RotemCarr/snowboard-fc/hardware/docs/pinmap.md

# Snowboard Rev 3 pin map

Generated by `tools/gen_pinmap.py` from `snowboard_fc.kicad_sch`. Do not edit by hand:
change the schematic (and `EXPECTED` in the script if a pin moves), then regenerate.
Authoritative for the board DTS and pinctrl. Spec: SNB-HW-001 section 7.

## GPIO

| GPIO | Pin | Net | Peripheral | Dir | Connects to |
| --- | --- | --- | --- | --- | --- |
| 0 | 2 | `RX_TX` | UART0 TX | out | R24 100R → J3.3 (FC_TX) RX 4-pin SH |
| 1 | 3 | `RX_RX` | UART0 RX | in | R25 100R → J3.4 (FC_RX) RX 4-pin SH |
| 2 | 4 | `IMU_SCK` | SPI0 SCK | out | R10 33R → U5.13 (AP_SCLK) ICM-42688-P |
| 3 | 5 | `IMU_MOSI` | SPI0 TX | out | U5.14 (AP_SDI) ICM-42688-P |
| 4 | 7 | `IMU_MISO` | SPI0 RX | in | U5.1 (AP_SDO/AD0) ICM-42688-P |
| 5 | 8 | `IMU_CS` | GPIO (SPI0 CS) | out | U5.12 (AP_CS) ICM-42688-P |
| 6 | 9 | `IMU_INT1` | GPIO interrupt | in | U5.4 (INT1) ICM-42688-P |
| 7 | 10 | — | not connected | — | — |
| 8 | 12 | `M1` | PIO0 (DShot) | out | R16 100R → J1.3 (M1) ESC 8-pin SH |
| 9 | 13 | `M2` | PIO0 (DShot) | out | R17 100R → J1.4 (M2) ESC 8-pin SH |
| 10 | 14 | `M3` | PIO0 (DShot) | out | R18 100R → J1.5 (M3) ESC 8-pin SH |
| 11 | 15 | `M4` | PIO0 (DShot) | out | R19 100R → J1.6 (M4) ESC 8-pin SH |
| 12 | 16 | `AUX_TX` | PIO UART TX | out | JP1.3 (TX1) UART1 pads |
| 13 | 17 | `AUX_RX` | PIO UART RX | in | JP1.4 (RX1) UART1 pads |
| 14 | 18 | `I2C_SDA` | I2C1 SDA | bidir | JP2.3 (SDA) I2C pads; R26 4.7k to `+3V3` |
| 15 | 19 | `I2C_SCL` | I2C1 SCL | out | JP2.4 (SCL) I2C pads; R27 4.7k to `+3V3` |
| 16 | 27 | `WS_DATA` | PIO1 (WS2812) | out | R31 100R → U6.2 (A) 74AHCT1G125GW |
| 17 | 28 | `STATUS_LED` | GPIO | out | R30 1k → D2.2 LED blue |
| 18 | 29 | `BUZZ` | GPIO | out | R29 1k → Q1.1 (G) 2N7002 |
| 19 | 31 | — | not connected | — | — |
| 20 | 32 | — | not connected | — | — |
| 21 | 33 | — | not connected | — | — |
| 22 | 34 | `ESC_TEL` | PIO UART RX | in | R20 1k → J1.8 (TEL) ESC 8-pin SH |
| 23 | 35 | — | not connected | — | — |
| 24 | 36 | — | not connected | — | — |
| 25 | 37 | — | not connected | — | — |
| 26 | 40 | `VBAT_SENSE` | ADC0 | in | C33 100nF to `GND`; R21 100k 1% to `BAT_F`; R22 10k to `GND` |
| 27 | 41 | `CUR_SENSE` | ADC1 | in | C34 100nF to `GND`; D6.3 (COM) BAT54S; R23 10k → J1.7 (CUR) ESC 8-pin SH |
| 28 | 42 | `RSSI` | ADC2 | in | R28 10k → JP4.1 (RSSI) RSSI pad |
| 29 | 43 | — | not connected | — | — |

Notes:

- GPIO12/13 offer only UART0 (already used by the receiver on GPIO0/1) and GPIO22 offers only
  UART1 TX, so the aux UART and ESC telemetry use PIO UARTs (SNB-HW-001 L-07).
- ADC inputs are limited to GPIO26–29 on the RP2350A.
- RP2350 erratum E9: internal pull-downs are not used on any input.

## Dedicated pins

| Pin | Function | Net | Connects to |
| --- | --- | --- | --- |
| 21 | XIN | `MCU/XIN` | C18 15pF C0G to `GND`; Y1.1 (1) 12MHz ABM8-272-T3 |
| 22 | XOUT | `MCU/XOUT` | R3 1k → C19.1 15pF C0G, Y1.3 (3) 12MHz ABM8-272-T3 |
| 24 | SWCLK | `MCU/SWCLK` | J4.1 (SWCLK) SWD 3-pin SH |
| 25 | SWDIO | `MCU/SWDIO` | J4.3 (SWDIO) SWD 3-pin SH |
| 26 | RUN | `MCU/RUN` | C20 100nF to `GND`; R4 10k to `+3V3`; TP1.1 (1) RUN |
| 46 | VREG_AVDD | `MCU/VREG_AVDD` | C4 4.7uF to `GND`; R1 33R to `+3V3` |
| 48 | VREG_LX | `MCU/VREG_LX` | L2 3.3uH to `MCU/DVDD` |
| 51 | USB_D- | `USB_DM` | R14 27R → D5.1 (I/O1) USBLC6-2SC6, D5.6 (I/O1) USBLC6-2SC6, J2.A7 (D-) USB-C 2.0, J2.B7 (D-) USB-C 2.0 |
| 52 | USB_D+ | `USB_DP` | R15 27R → D5.3 (I/O2) USBLC6-2SC6, D5.4 (I/O2) USBLC6-2SC6, J2.A6 (D+) USB-C 2.0, J2.B6 (D+) USB-C 2.0 |
| 55 | QSPI_SD3 | `MCU/QSPI_SD3` | U2.7 (IO3) W25Q32JVSNIQ |
| 56 | QSPI_SCLK | `MCU/QSPI_SCLK` | U2.6 (CLK) W25Q32JVSNIQ |
| 57 | QSPI_SD0 | `MCU/QSPI_SD0` | U2.5 (DI(IO0)) W25Q32JVSNIQ |
| 58 | QSPI_SD2 | `MCU/QSPI_SD2` | U2.3 (IO2) W25Q32JVSNIQ |
| 59 | QSPI_SD1 | `MCU/QSPI_SD1` | U2.2 (DO(IO1)) W25Q32JVSNIQ |
| 60 | QSPI_CS | `MCU/QSPI_SS` | R2 10k to `+3V3`; R5 1k → SW1.1 (1) BOOTSEL; U2.1 (~{CS}) W25Q32JVSNIQ |

## Supply pins

| Net | Pins |
| --- | --- |
| `+3V3` | IOVDD (1), IOVDD (11), IOVDD (20), IOVDD (30), IOVDD (38), ADC_AVDD (44), IOVDD (45), VREG_VIN (49), USB_OTP_VDD (53), QSPI_IOVDD (54) |
| `GND` | VREG_PGND (47), GND (EP) |
| `MCU/DVDD` | DVDD (6), DVDD (23), DVDD (39), VREG_FB (50) |
