RotemCarr/snowboard-fc/hardware/docs/snowboard_fc_pcb_layers.png

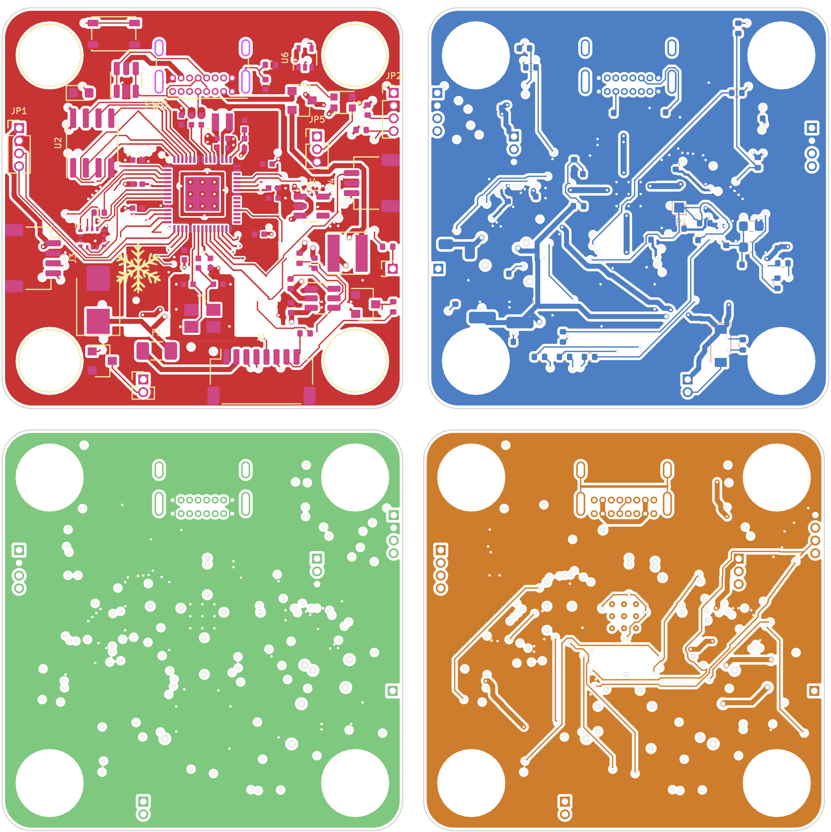
hardware/docs/snowboard_fc_pcb_layers.png
