RotemCarr/snowboard-fc/hardware/fab/rev3/snowboard_fc_JLC_BOM_v7.csv

Comment | Designator | Footprint | LCSC Part #
4.7uF 10V X5R | C1,C4,C5 | 0402 | C23733
100nF 16V X7R | C2,C3,C6,C7,C8,C9,C10,C11,C12,C13,C14,C16,C17,C20,C24,C30,C33,C34,C35,C36 | 0402 | C1525
1uF 25V X5R | C15,C27,C28 | 0402 | C52923
15pF 50V C0G | C18,C19 | 0402 | C1548
10uF 100V X7R | C21,C22 | 1210 | C5156756
100nF 50V X7R | C23 | 0402 | C307331
22uF 25V X5R | C25,C26 | 0805 | C45783
2.2uF 16V X5R | C29 | 0603 | C23630
10nF 50V X7R | C31 | 0402 | C696350
4.7nF 50V X7R | C32 | 0402 | C1538
BAT54C | D1 | SOT-23 | C22466350
LED blue 0603 | D2 | 0603 | C125096
SMBJ26A | D3 | SMB | C3019963
XINGLIGHT XL-1615RGBC-WS2812B | D4 | 1615 | C5349954
USBLC6-2SC6 | D5 | SOT-23-6 | C7519
BAT54S | D6 | SOT-23 | C7420333
1N4148W | D7 | SOD-123 | C81598
F12F1 fuse 1A fast 1206 32V | F1 | 1206 | C2924985
600R@100MHz ferrite | FB1 | 0603 | C1002
JST SM08B-SRSS-TB(LF)(SN) 8-pin SH side entry | J1 | SH-1.0mm-8P-RA | C160407
GCT USB4085-GF-A USB-C 2.0 (through-hole) - Global Sourcing | J2 | USB-C THT
JST SM04B-SRSS-TB(LF)(SN) 4-pin SH side entry | J3 | SH-1.0mm-4P-RA | C160404
JST SM03B-SRSS-TB(LF)(SN) 3-pin SH side entry | J4 | SH-1.0mm-3P-RA | C160403
10uH 4x4mm shielded | L1 | 4x4mm | C340371
AOTA-B201610S3R3-101-T 3.3uH (RP2350 recommended) | L2 | 0806 | C42411119
2N7002 | Q1 | SOT-23 | C8545
33R 1% 0402 | R1,R10 | 0402 | C25105
10k 1% 0402 | R2,R4,R22,R23,R28 | 0402 | C25744
1k 1% 0402 | R3,R5,R20,R29,R30 | 0402 | C11702
100k 1% 0402 | R6,R8,R21 | 0402 | C25741
20k 1% 0402 | R7 | 0402 | C25765
13.3k 1% 0402 | R9 | 0402 | C122547
5.1k 1% 0402 | R11,R12 | 0402 | C25905
1M 1% 0402 | R13 | 0402 | C26083
27R 1% 0402 | R14,R15 | 0402 | C25100
100R 1% 0402 | R16,R17,R18,R19,R24,R25,R31 | 0402 | C25076
4.7k 1% 0402 | R26,R27 | 0402 | C25900
330R 1% 0402 | R32 | 0402 | C25104
C&K PTS810SJM250SMTRLFS tactile switch - Global Sourcing | SW1 | SMD
RP2350A | U1 | QFN-60 | C42411118
W25Q32JVSNIQ | U2 | SOIC-8 | C5355146
TPS54202DDCT | U3 | SOT-23-6 | C2070672
AP2112K-3.3TRG1 | U4 | SOT-23-5 | C51118
ICM-42688-P | U5 | LGA-14 | C1850418
74AHCT1G125GW | U6 | SOT-353 | C52953352
ABM8-272-T3 12MHz 10pF (RP2350 recommended) | Y1 | 3225 | C20625731
