RotemCarr/snowboard-fc/hardware/docs/schematic-rev3.pdf

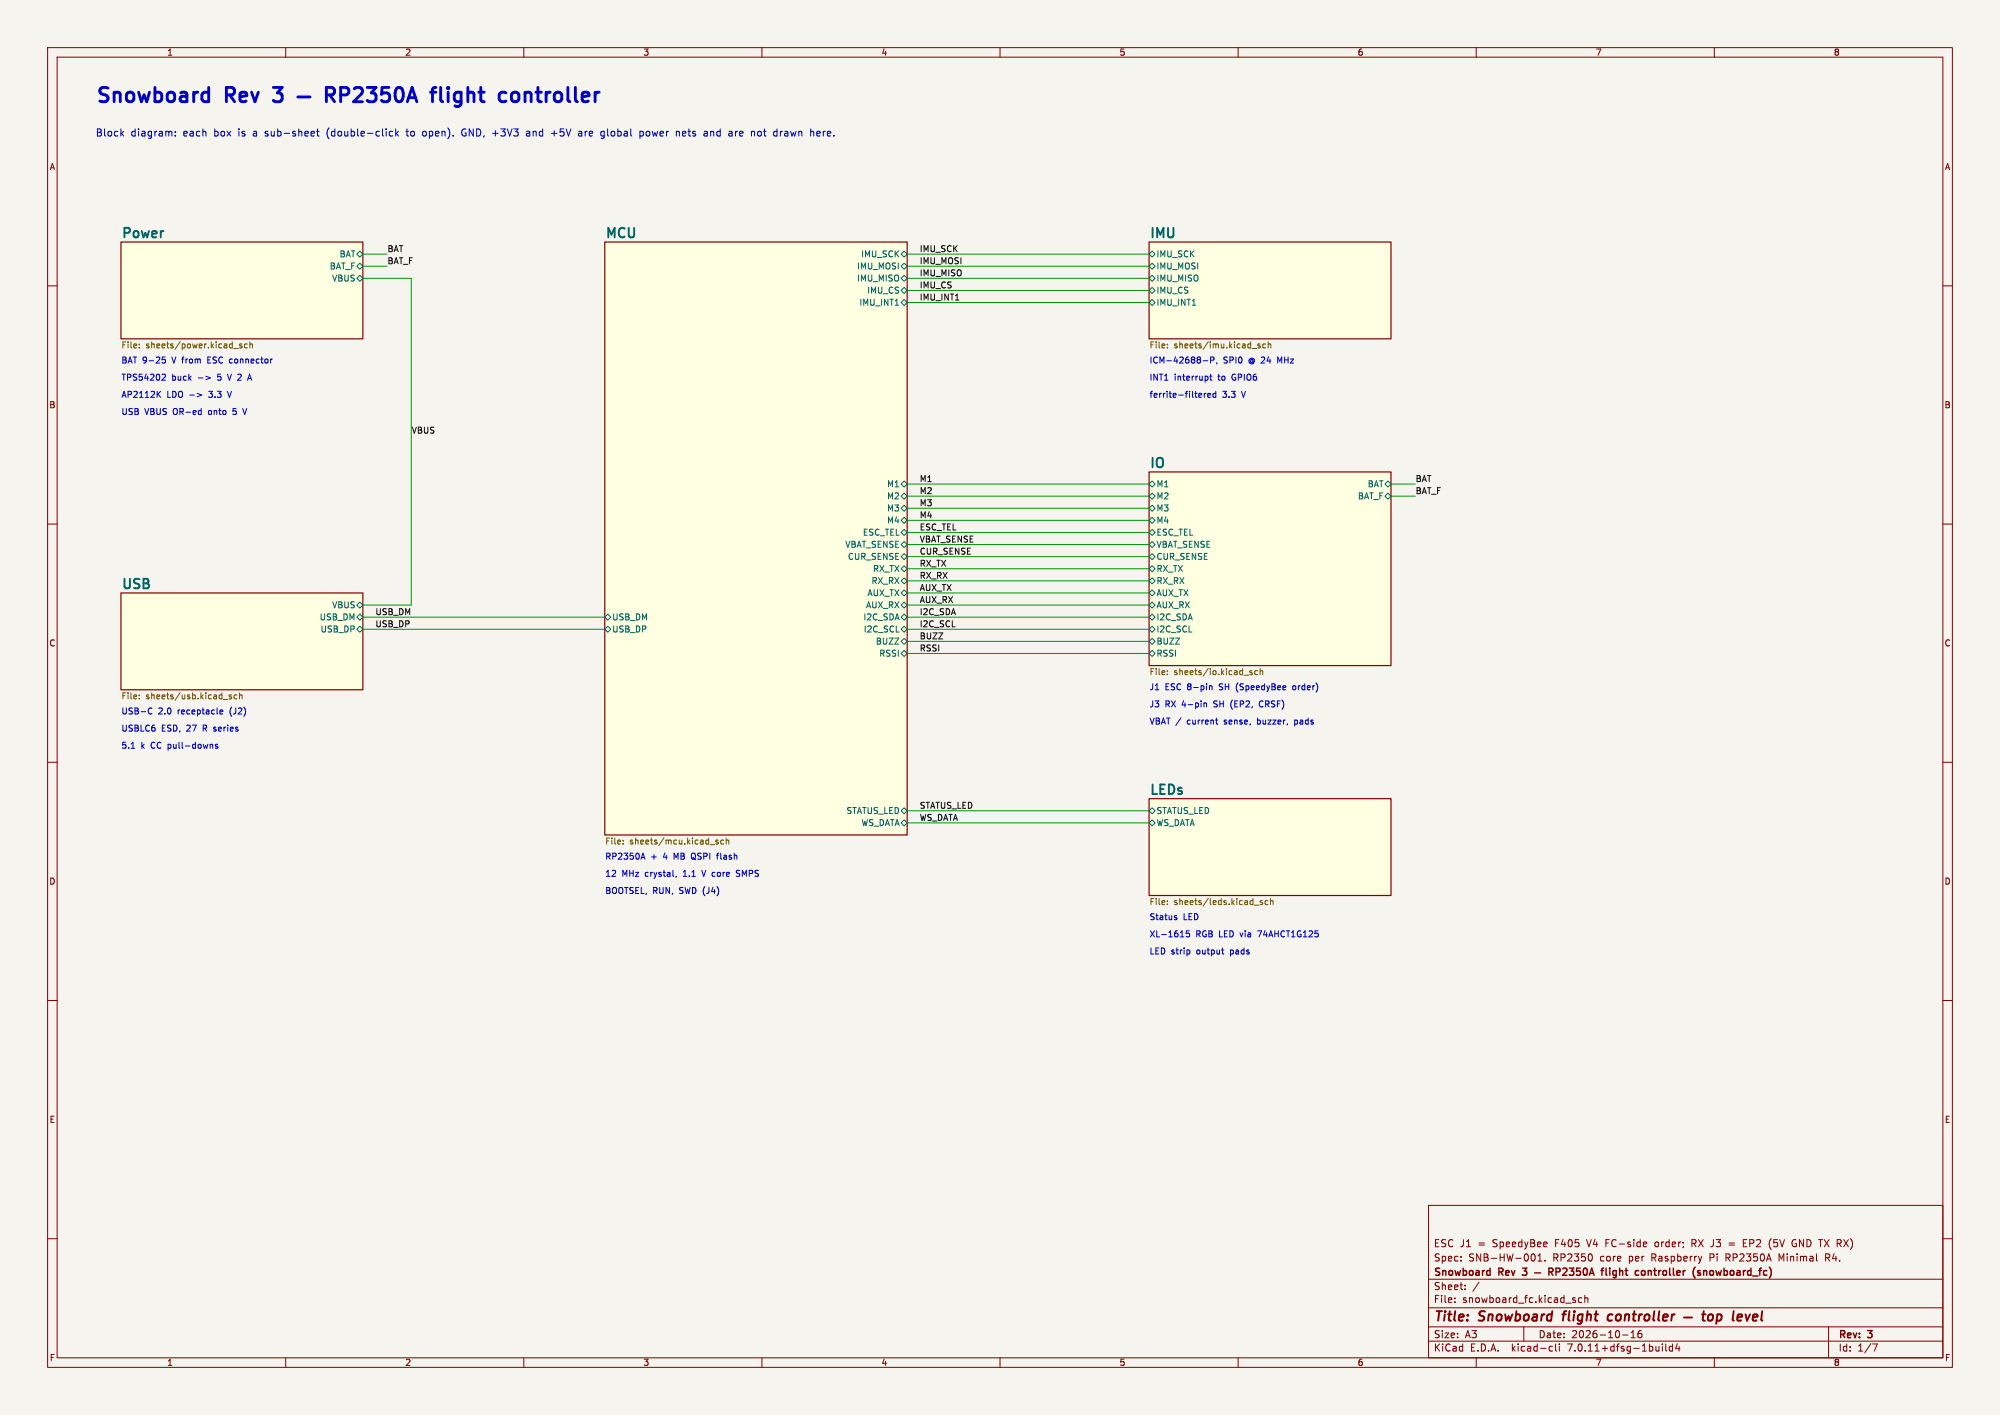
[picture p2: page 1]

File: sheets/imu.kicad_sch VBUS USB_DM

VBAT / current sense, buzzer, pads

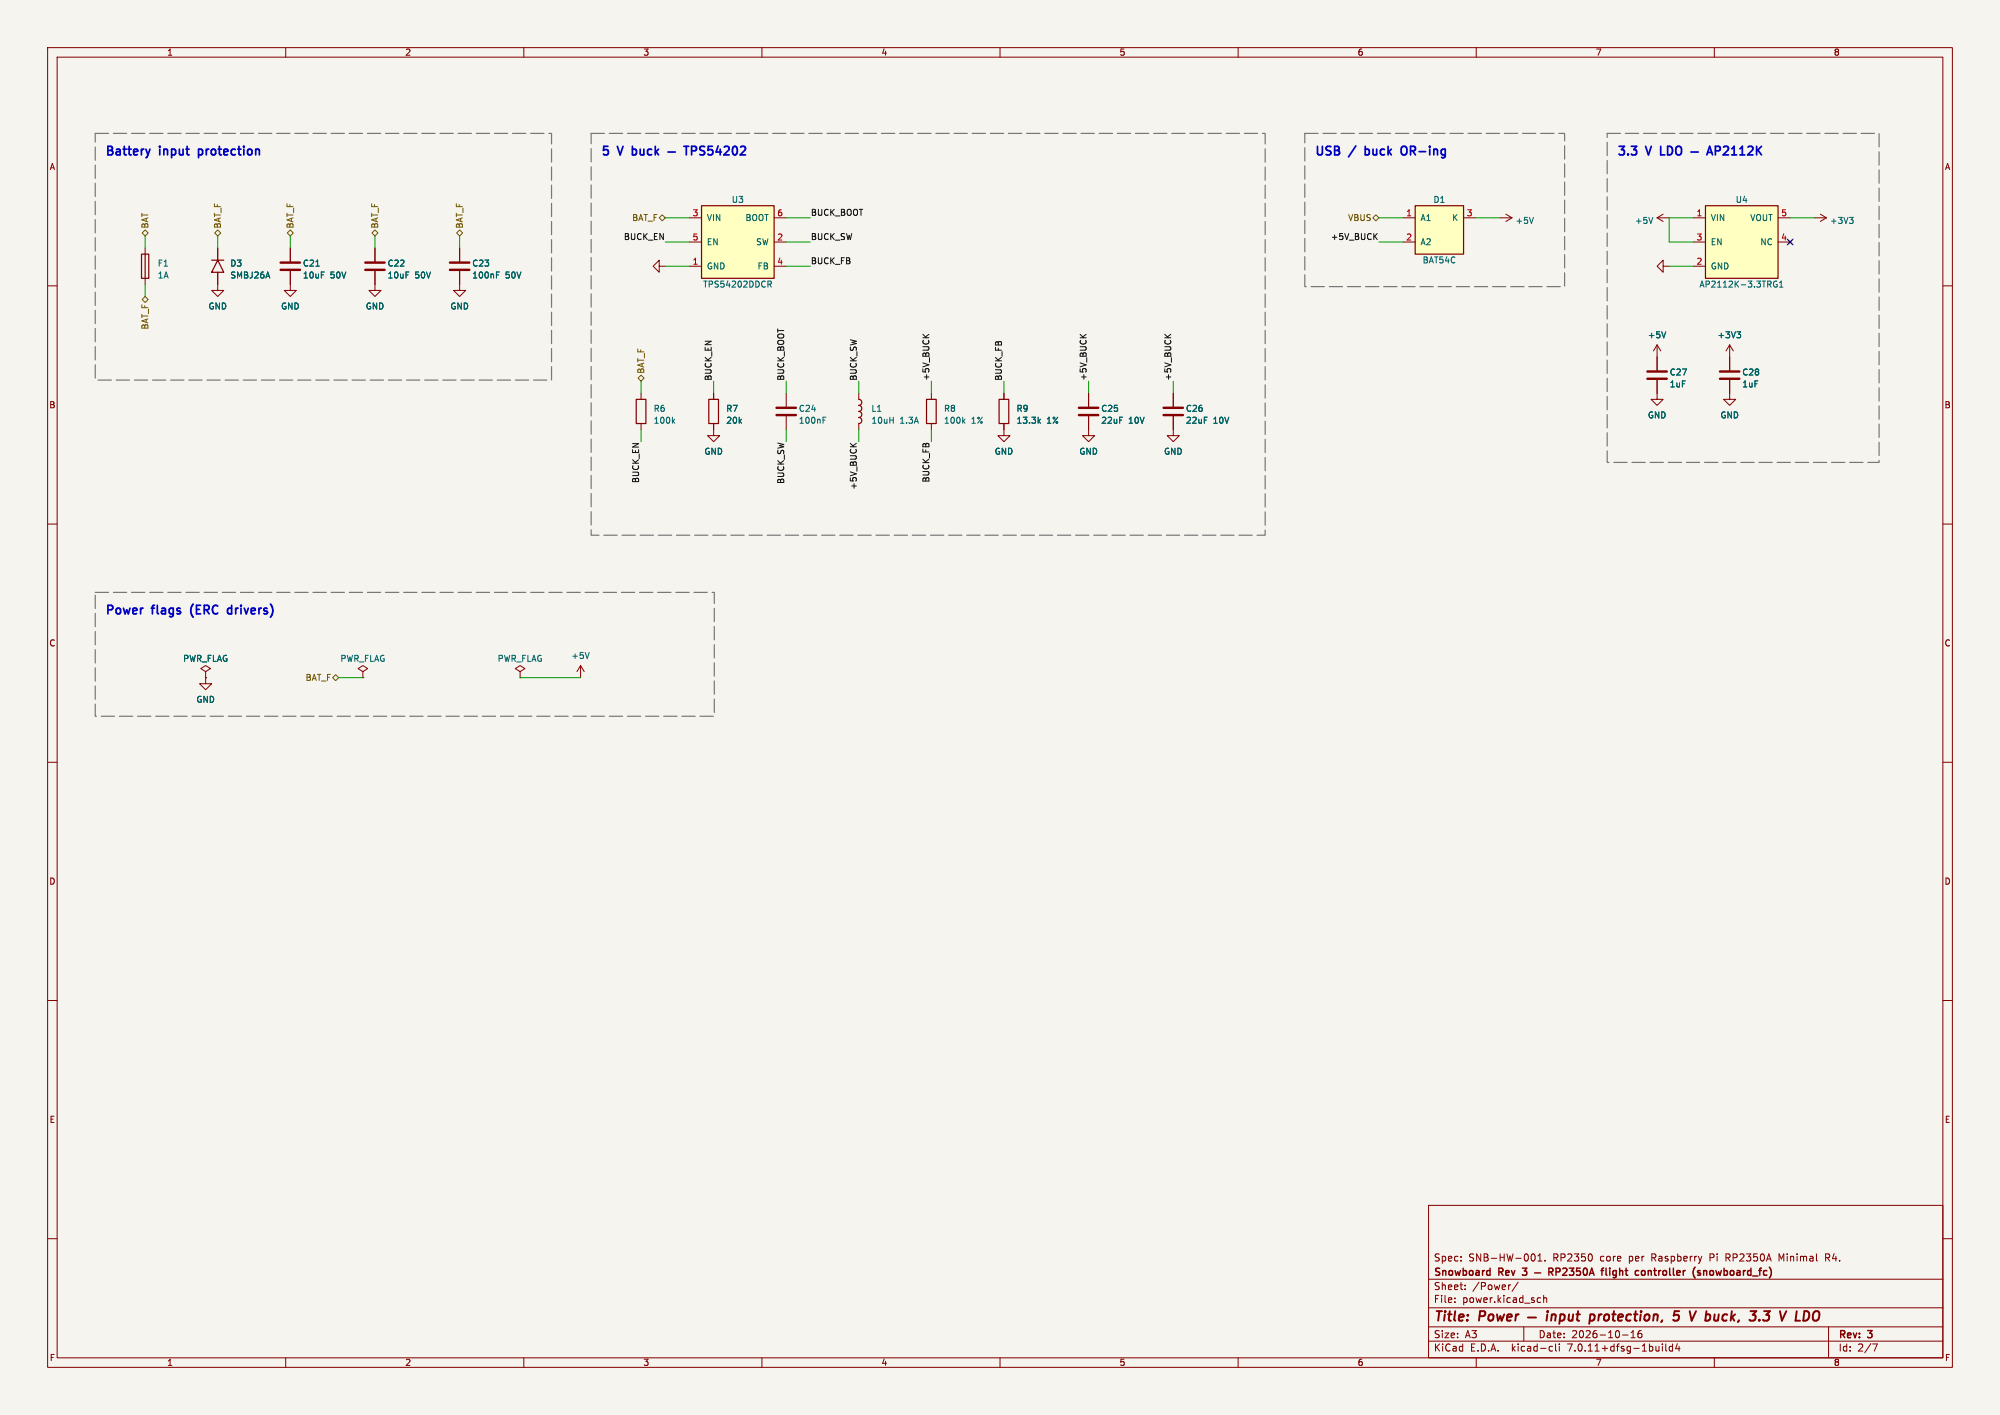
[picture p3: page 2]

Power flags (ERC drivers)

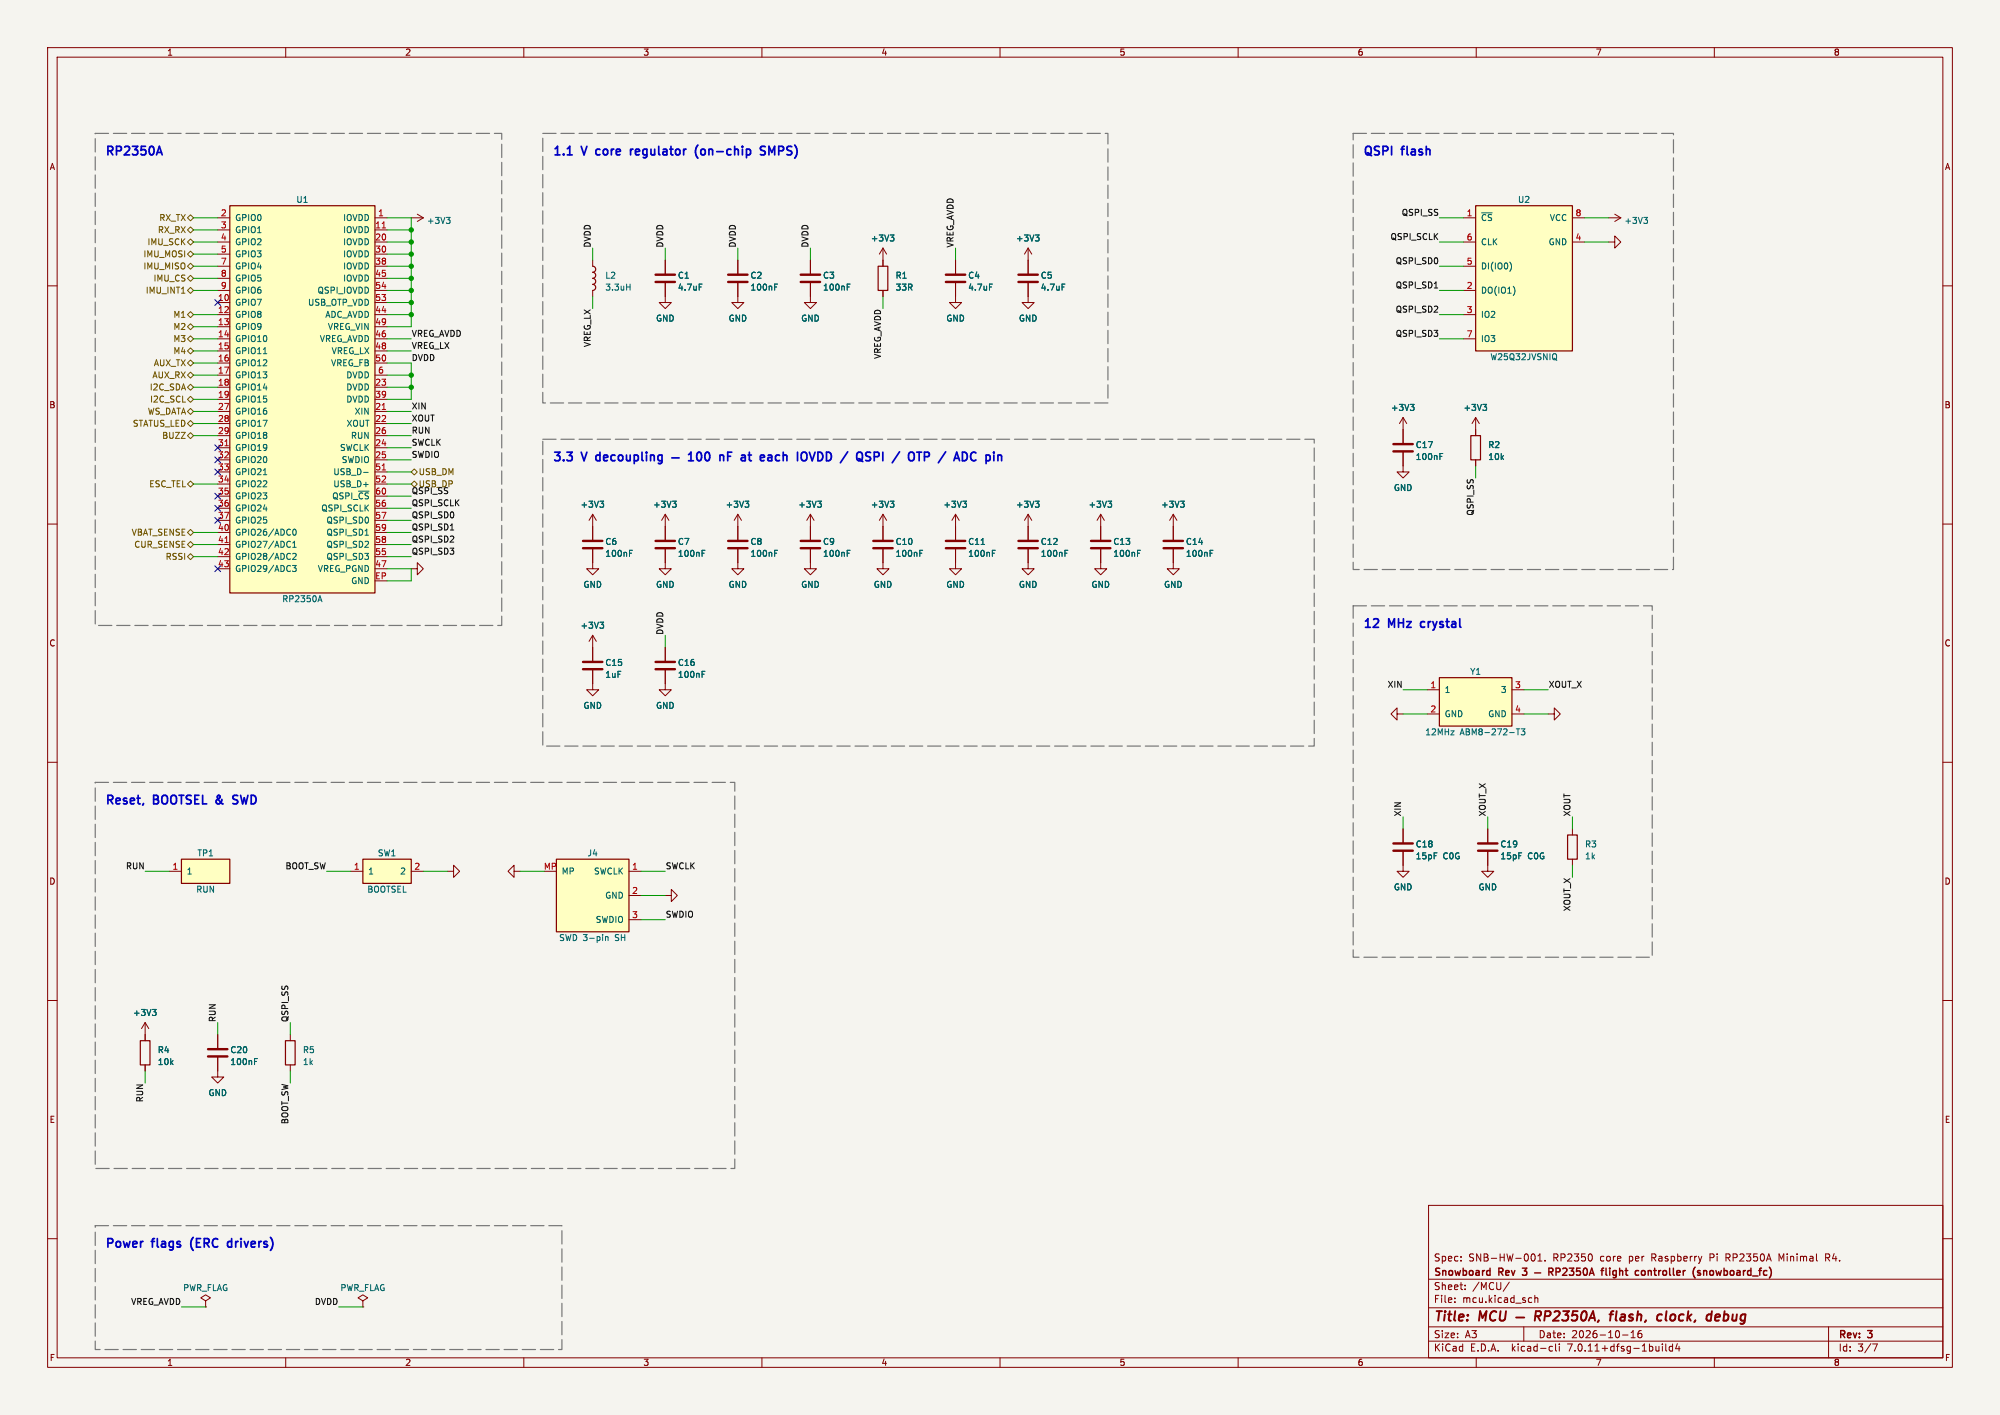
[picture p4: page 3]

3.3 V decoupling þÿ 100 nF at each IOVDD / QSPI / OTP / ADC pin

SWCLK 1 GND 2 SWDIO 3 MP MP

VREG_AVDD Power flags (ERC drivers)

Id: 3/7 Title: MCU þÿ RP2350A, flash, clock, debug

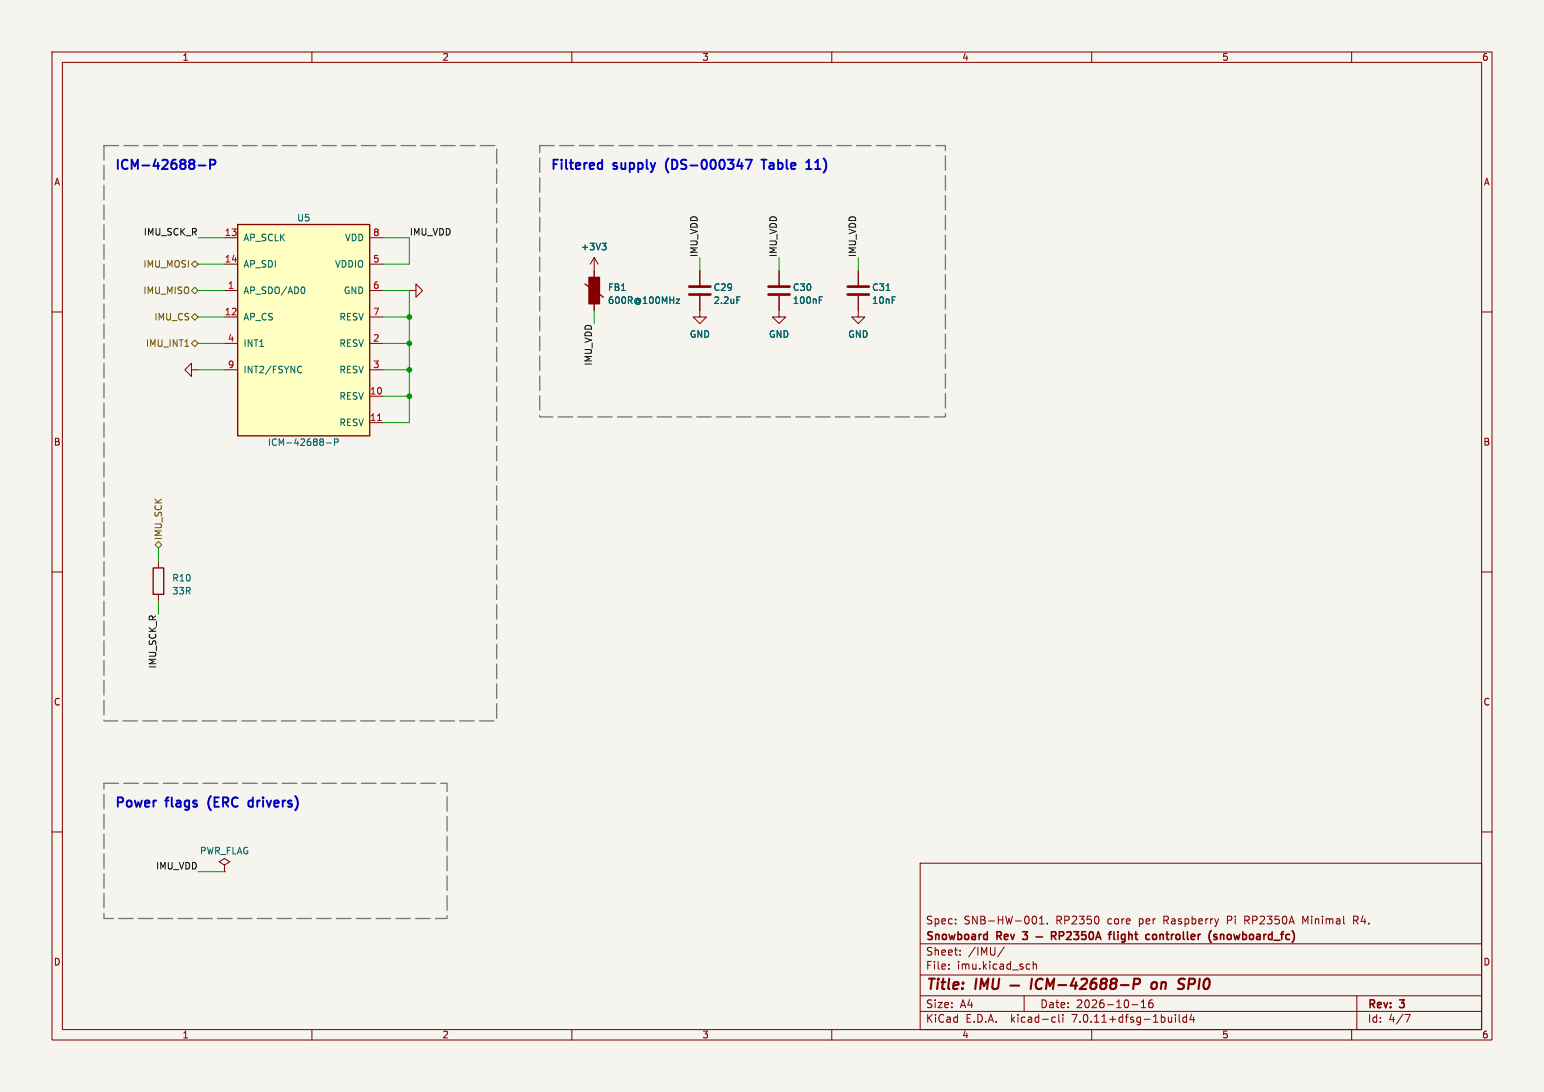
[picture p5: page 4]

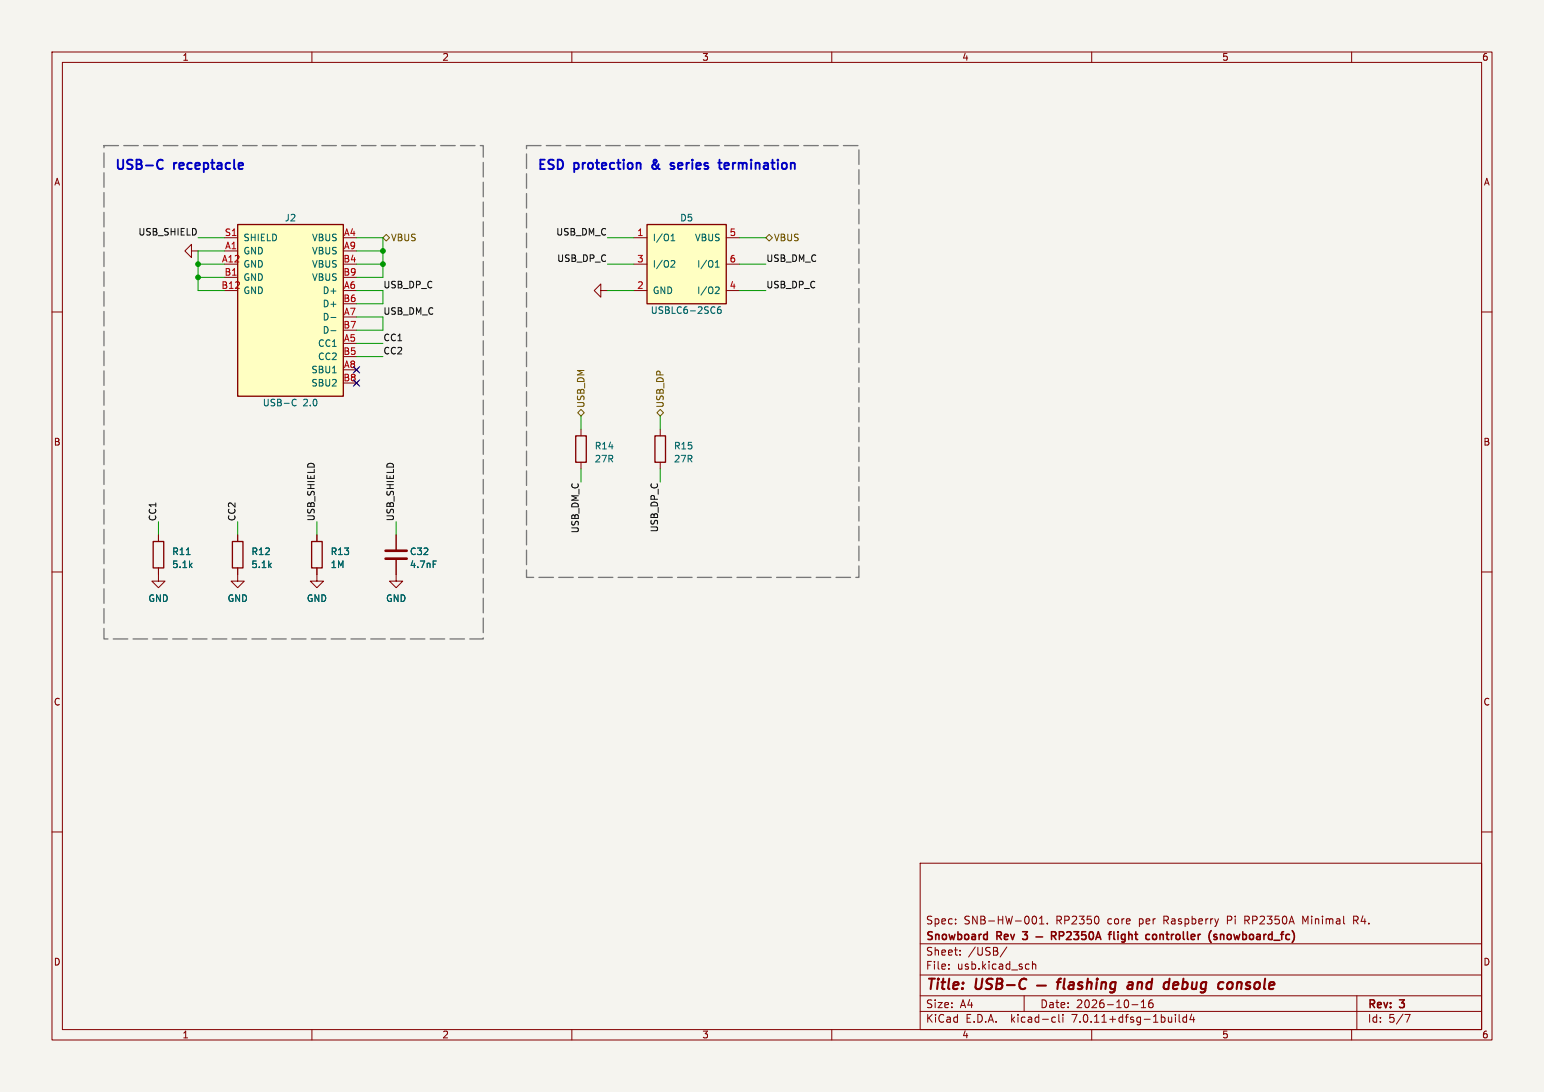
[picture p6: page 5]

Id: 5/7 Title: USB-C þÿ flashing and debug console

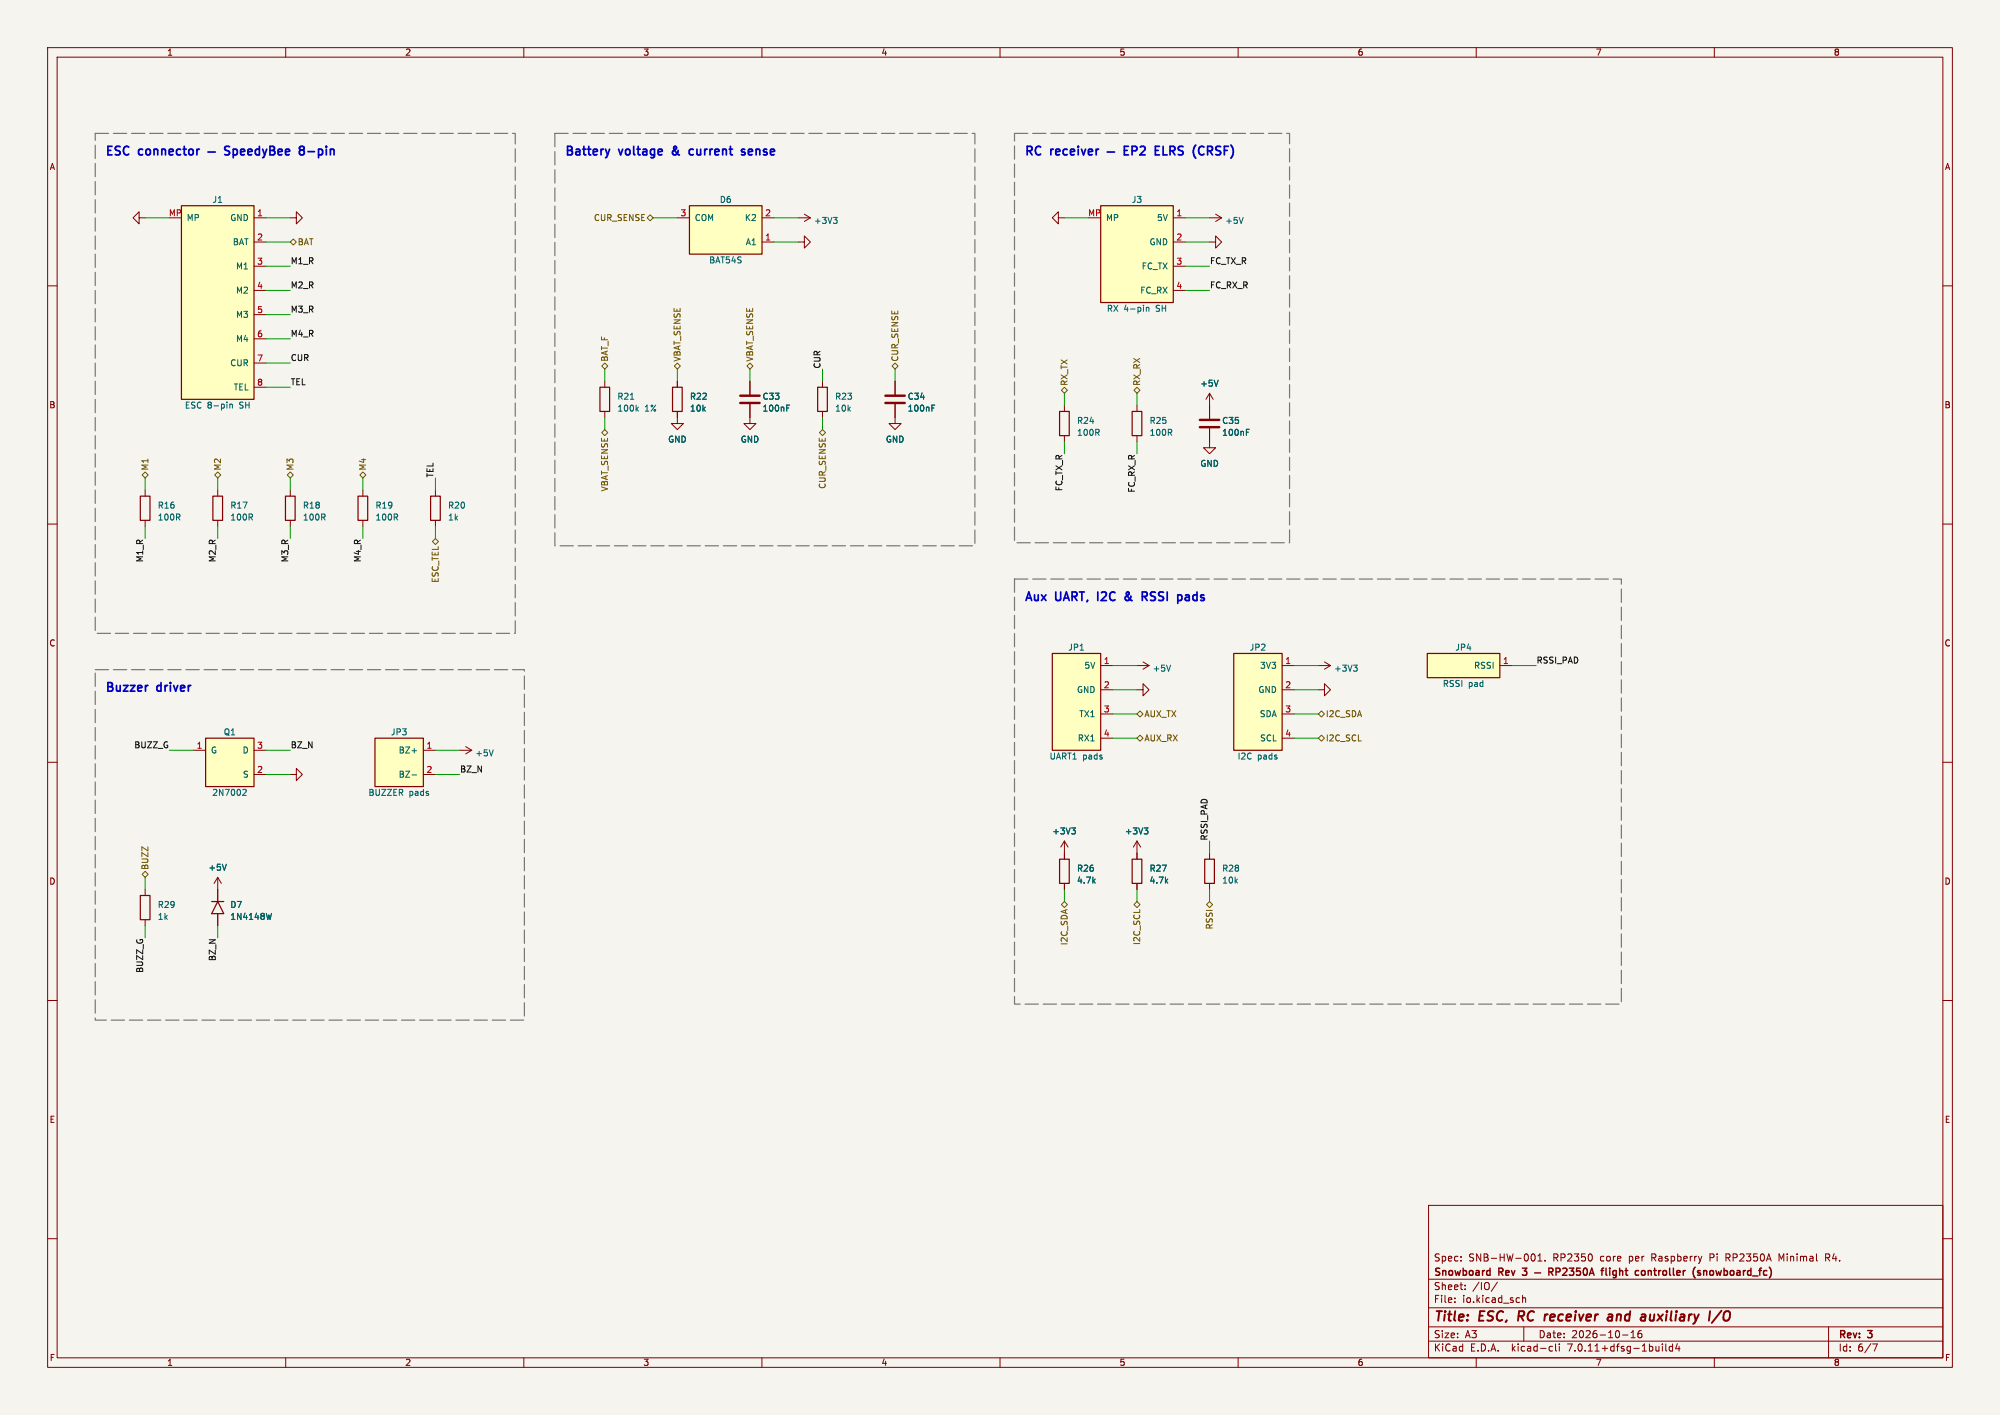
[picture p7: page 6]

RC receiver þÿ EP2 ELRS (CRSF)

Id: 6/7 Title: ESC, RC receiver and auxiliary I/O

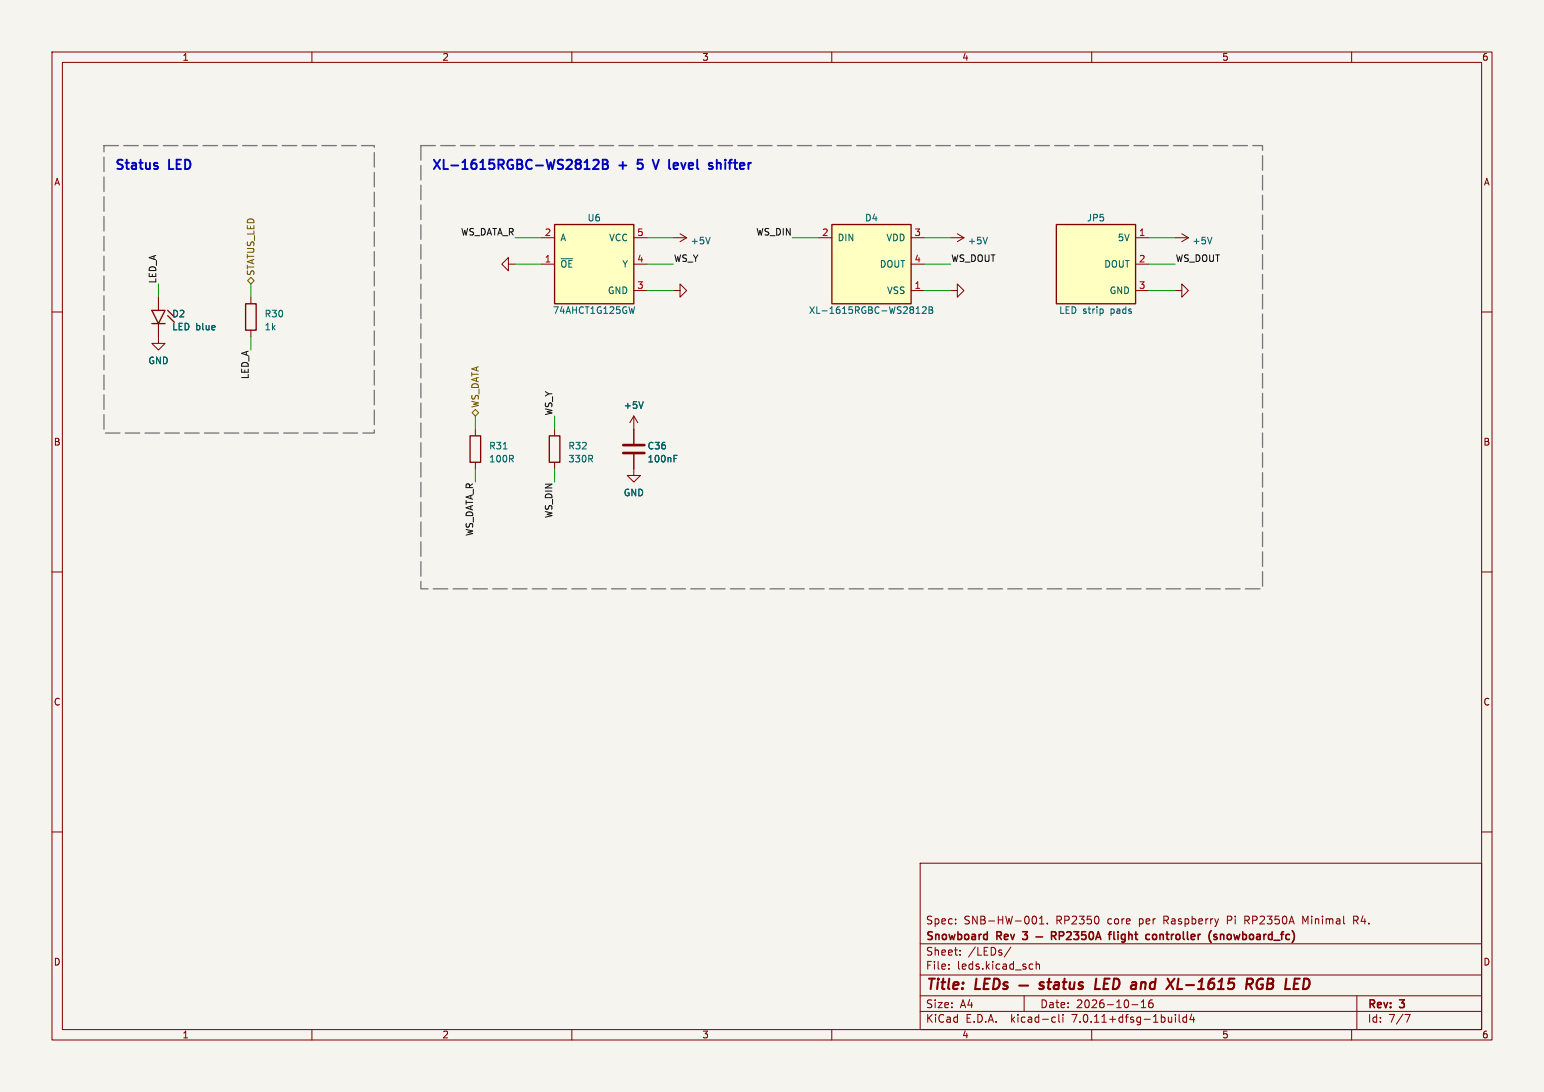
[picture p8: page 7]
