RotemCarr/snowboard-fc/hardware/snowboard_fc.kicad_pcb

## KiCad design hardware/snowboard_fc.kicad_pcb (2026-10-16)

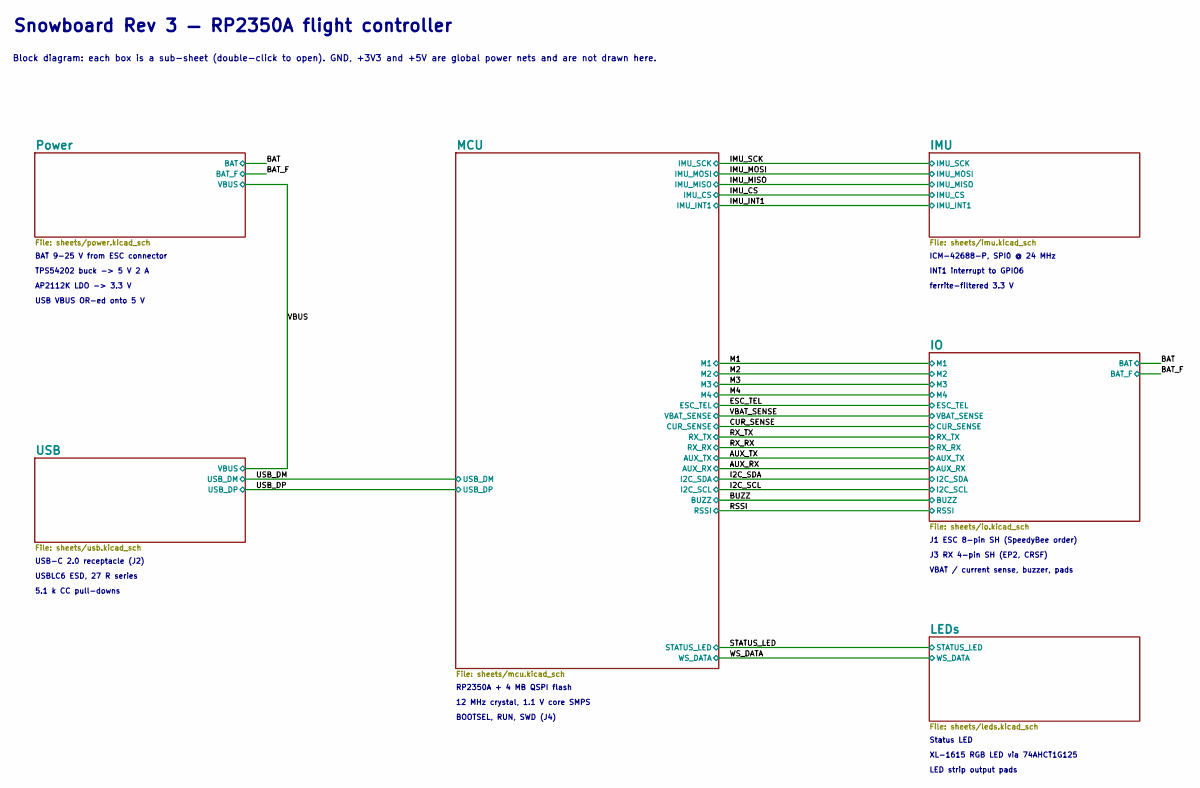
[picture p9: schematic snowboard_fc.kicad_sch, Snowboard flight controller — top level]

Notes on the sheet:
Snowboard Rev 3 — RP2350A flight controller
Block diagram: each box is a sub-sheet (double-click to open). GND, +3V3 and +5V are global power nets and are not drawn here.
BAT 9-25 V from ESC connector
TPS54202 buck -> 5 V 2 A
AP2112K LDO -> 3.3 V
USB VBUS OR-ed onto 5 V
RP2350A + 4 MB QSPI flash
12 MHz crystal, 1.1 V core SMPS
BOOTSEL, RUN, SWD (J4)
ICM-42688-P, SPI0 @ 24 MHz
INT1 interrupt to GPIO6
ferrite-filtered 3.3 V
USB-C 2.0 receptacle (J2)
USBLC6 ESD, 27 R series
5.1 k CC pull-downs
J1 ESC 8-pin SH (SpeedyBee order)
J3 RX 4-pin SH (EP2, CRSF)
VBAT / current sense, buzzer, pads
Status LED
XL-1615 RGB LED via 74AHCT1G125
LED strip output pads

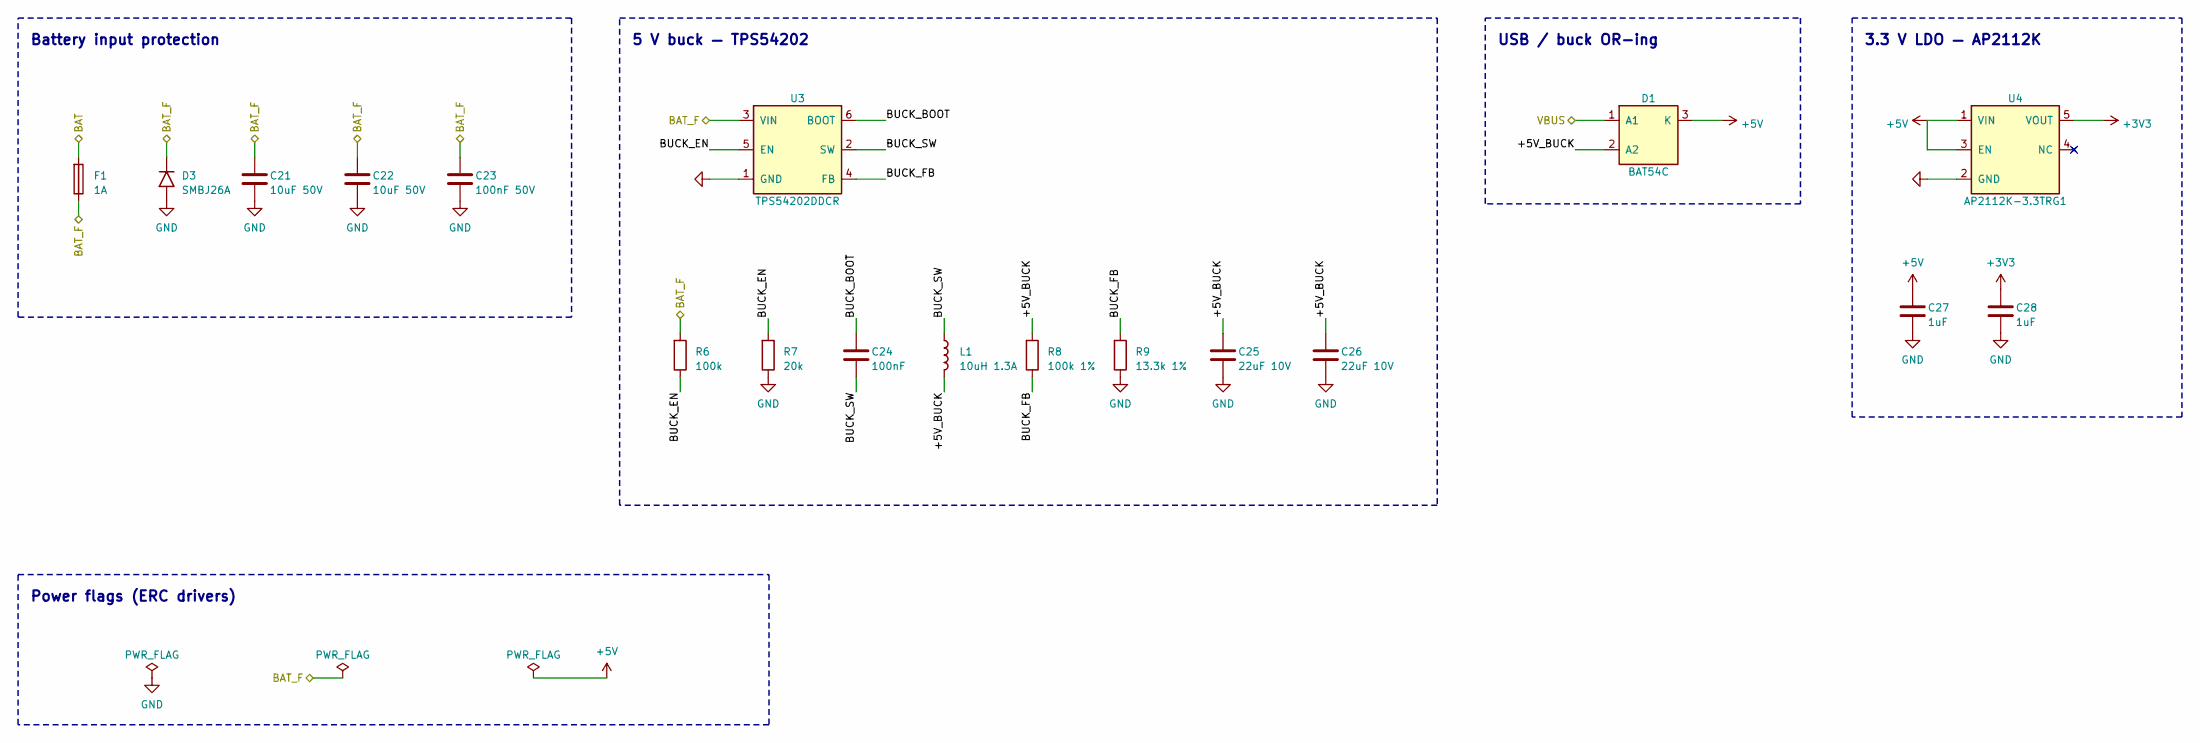
[picture p10: schematic power.kicad_sch, Power — input protection, 5 V buck, 3.3 V LDO]

Parts:
C21, C22: 10uF 50V; C_1210_3225Metric; LCSC C5156756
C23: 100nF 50V; C_0402_1005Metric; LCSC C307331
C24: 100nF; C_0402_1005Metric; LCSC C1525
C25, C26: 22uF 10V; C_0805_2012Metric; LCSC C45783
C27, C28: 1uF; C_0402_1005Metric; LCSC C52923
D1: BAT54C; SOT-23; MPN BAT54C; LCSC C22466350
D3: SMBJ26A; D_SMB; MPN SMBJ26A (Littelfuse); LCSC C3019963
F1: 1A; Fuse_1206_3216Metric; MPN F12F1 (TLC); LCSC C2924985
L1: 10uH 1.3A; L_Taiyo-Yuden_NR-40xx; MPN YNR4018-100M (YJYCOIN); LCSC C340371
R6: 100k; R_0402_1005Metric; LCSC C25741
R7: 20k; R_0402_1005Metric; LCSC C25765
R8: 100k 1%; R_0402_1005Metric; LCSC C25741
R9: 13.3k 1%; R_0402_1005Metric; LCSC C122547
U3: TPS54202DDCR; SOT-23-6; MPN TPS54202DDCR (TI); LCSC C2070672
U4: AP2112K-3.3TRG1; SOT-23-5; MPN AP2112K-3.3TRG1 (Diodes Inc); LCSC C51118

Connections:
+3V3: C28.1, U4.5 (VOUT); also elsewhere on the board
+5V: C27.1, D1.3 (K), U4.1 (VIN), U4.3 (EN); also elsewhere on the board
/BAT: F1.1; also elsewhere on the board
/BAT_F: C21.1, C22.1, C23.1, D3.1, F1.2, R6.1, U3.3 (VIN); also elsewhere on the board
/Power/+5V_BUCK: C25.1, C26.1, D1.2 (A2), L1.2, R8.1
/Power/BUCK_BOOT: C24.1, U3.6 (BOOT)
/Power/BUCK_EN: R6.2, R7.1, U3.5 (EN)
/Power/BUCK_FB: R8.2, R9.1, U3.4 (FB)
/Power/BUCK_SW: C24.2, L1.1, U3.2 (SW)
/VBUS: D1.1 (A1); also elsewhere on the board
GND: C21.2, C22.2, C23.2, C25.2, C26.2, C27.2, C28.2, D3.2, R7.2, R9.2, U3.1 (GND), U4.2 (GND); also elsewhere on the board

Notes on the sheet:
Battery input protection
5 V buck — TPS54202
USB / buck OR-ing
3.3 V LDO — AP2112K
Power flags (ERC drivers)

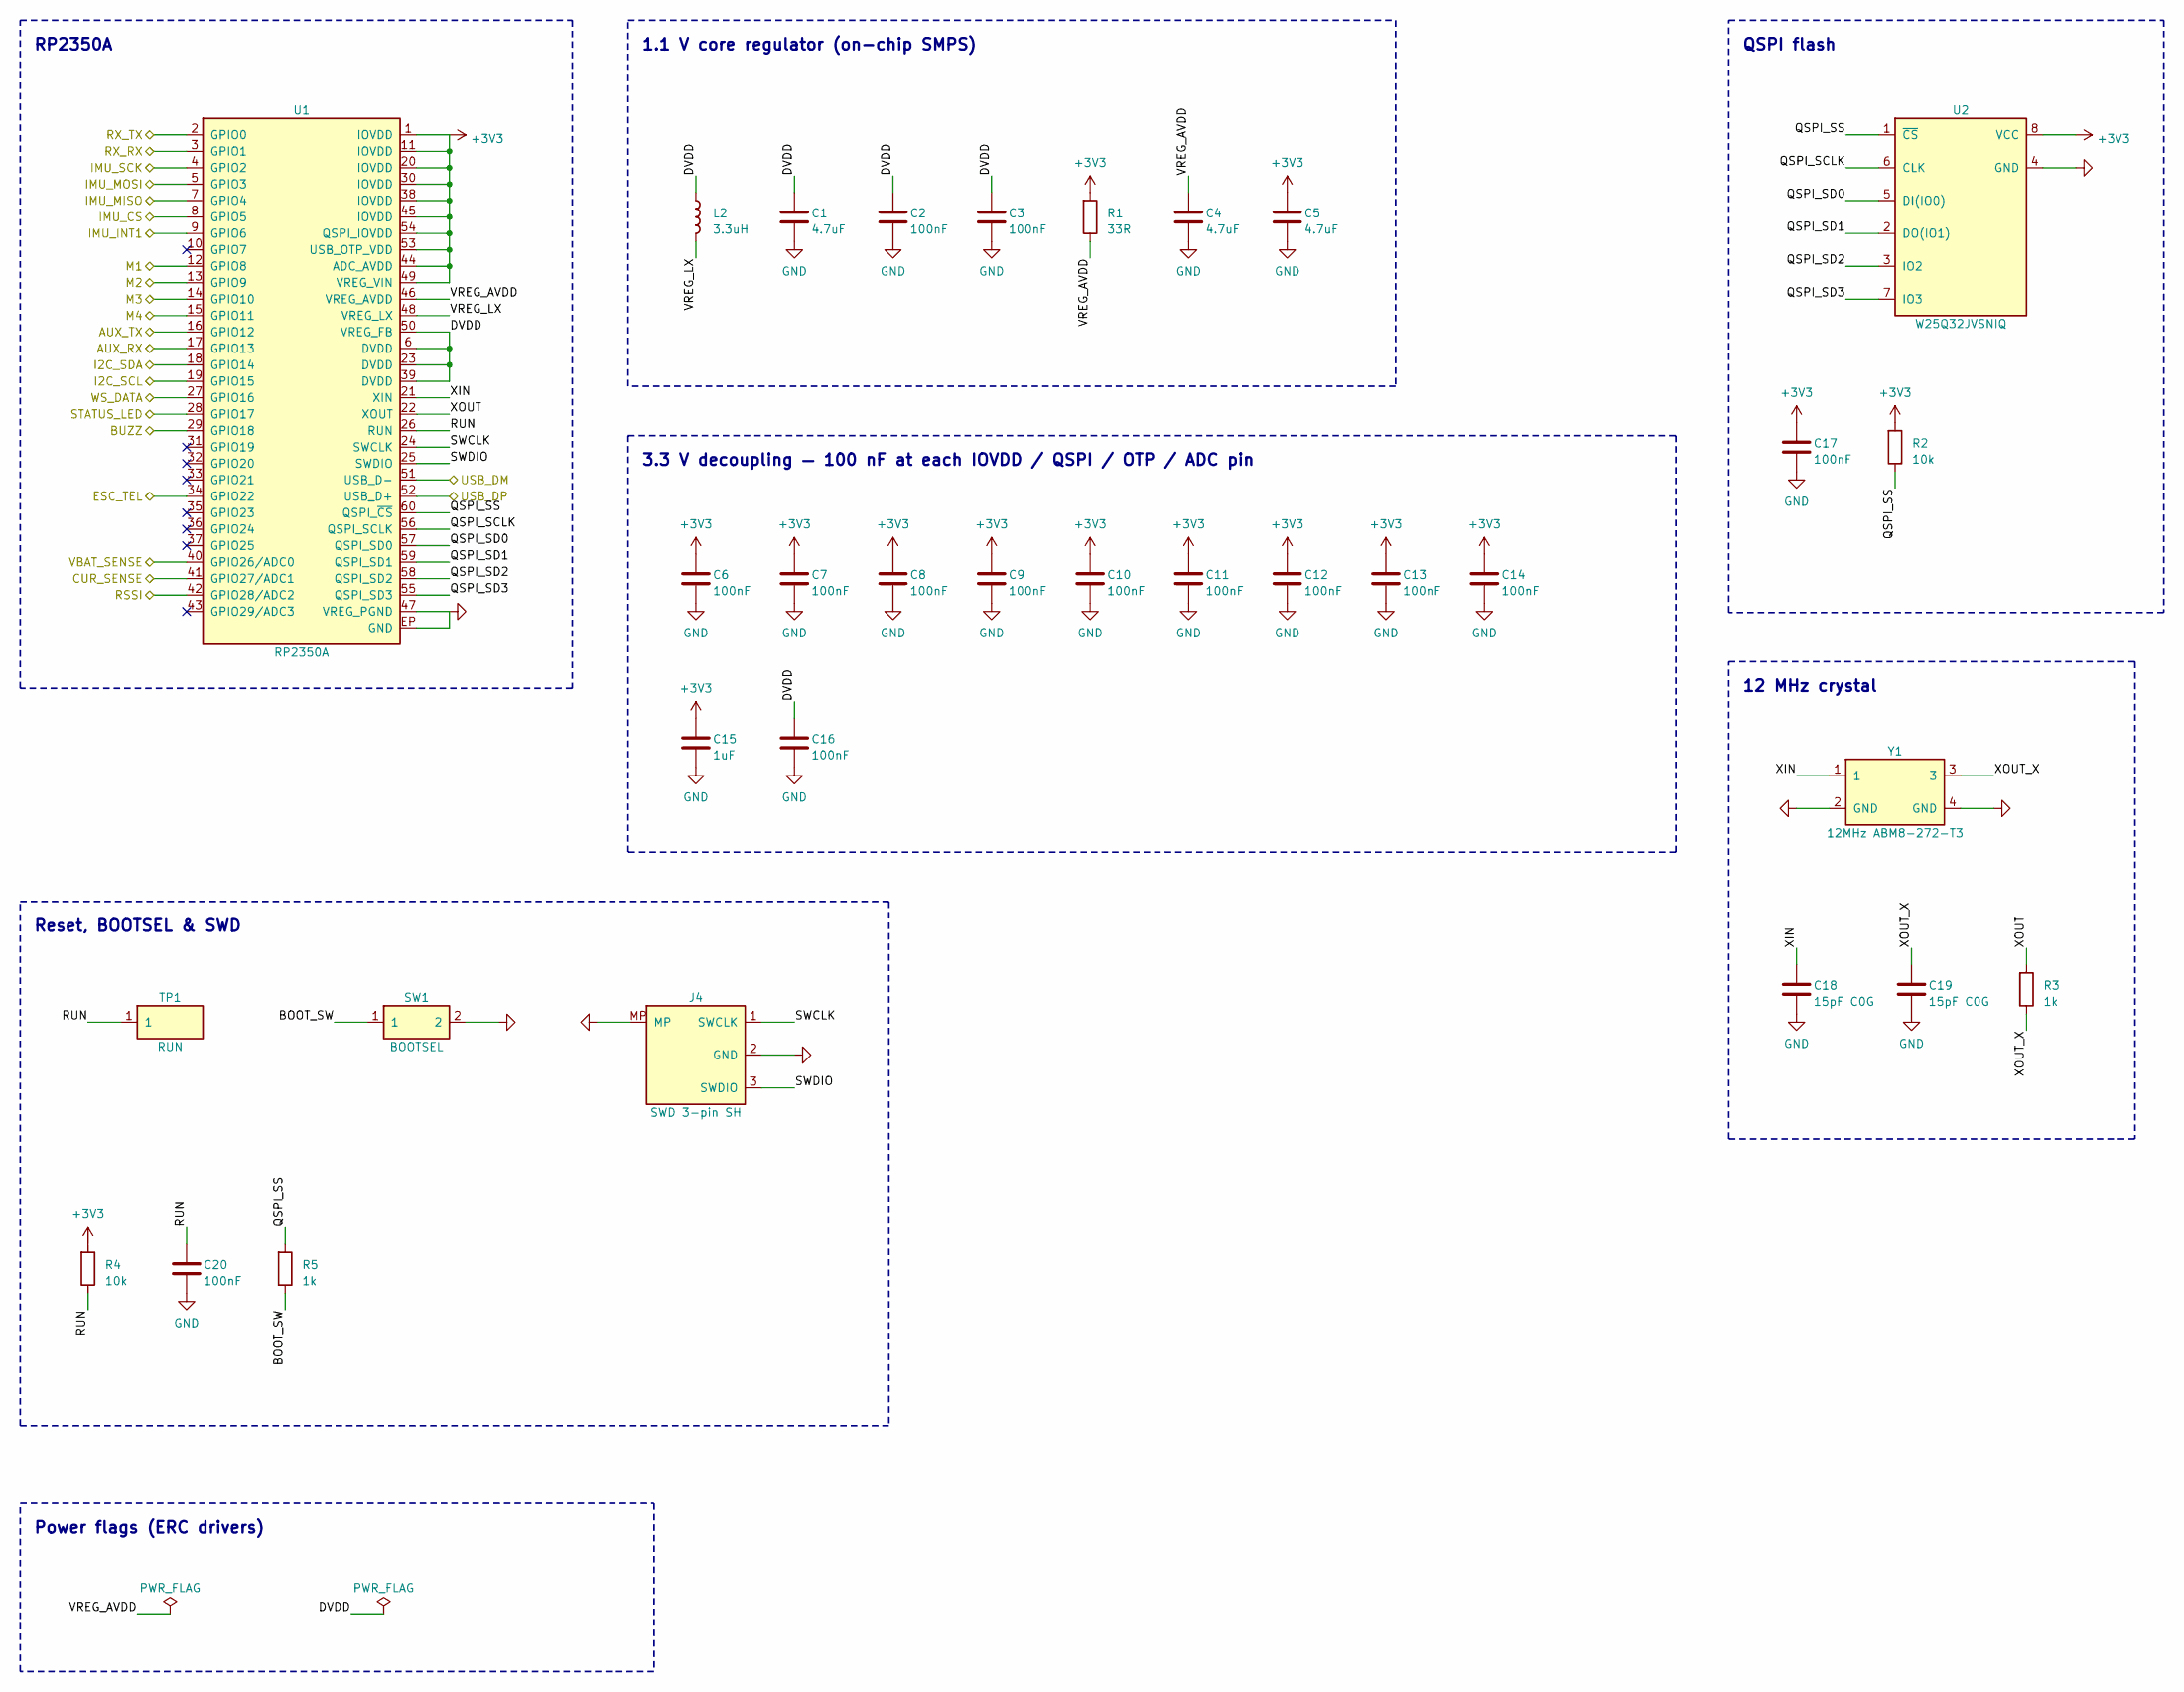
[picture p11: schematic mcu.kicad_sch, MCU — RP2350A, flash, clock, debug]

Parts:
C1, C5: 4.7uF; RPI_C_0402_capc1005x50_wide; LCSC C23733
C2, C3, C6, C7, C8, C9, C10, C11, C12, C16: 100nF; RPI_C_0402_capc1005x50; LCSC C1525
C4: 4.7uF; RPI_C_0402_capc1005x50; LCSC C23733
C13, C14, C17, C20: 100nF; C_0402_1005Metric; LCSC C1525
C15: 1uF; C_0402_1005Metric; LCSC C52923
C18, C19: 15pF C0G; RPI_C_0402_capc1005x50; LCSC C1548
J4: SWD 3-pin SH; JST_SH_SM03B-SRSS-TB_1x03-1MP_P1.00mm_Horizontal; MPN SM03B-SRSS-TB (JST)
L2: 3.3uH; RPI_L_AOTA-B201610S3R3-101-T; MPN AOTA-B201610S3R3-101-T (Abracon); LCSC C42411119
R1: 33R; RPI_R_0402_resc1005x35; LCSC C25105
R2, R4: 10k; R_0402_1005Metric; LCSC C25744
R3: 1k; RPI_R_0402_resc1005x35; LCSC C11702
R5: 1k; R_0402_1005Metric; LCSC C11702
SW1: BOOTSEL; SW_SPST_PTS810; MPN PTS810SJM250SMTRLFS (C&K)
TP1: RUN; TestPoint_Pad_1.0x1.0mm
U1: RP2350A; RPI_RP2350A_QFN60_vias; MPN RP2350A (Raspberry Pi); LCSC C42411118
U2: W25Q32JVSNIQ; SOIC-8_3.9x4.9mm_P1.27mm; MPN W25Q32JVSNIQ (Winbond); LCSC C5355146
Y1: 12MHz ABM8-272-T3; RPI_XTAL_3225_ABM8; MPN ABM8-272-T3 (Abracon); LCSC C20625731

Connections:
+3V3: C5.1, C6.1, C7.1, C8.1, C9.1, C10.1, C11.1, C12.1, C13.1, C14.1, C15.1, C17.1, R1.1, R2.1, R4.1, U1.1 (IOVDD), U1.11 (IOVDD), U1.20 (IOVDD), U1.30 (IOVDD), U1.38 (IOVDD), U1.44 (ADC_AVDD), U1.45 (IOVDD), U1.49 (VREG_VIN), U1.53 (USB_OTP_VDD), U1.54 (QSPI_IOVDD), U2.8 (VCC); also elsewhere on the board
/AUX_RX: U1.17 (GPIO13); also elsewhere on the board
/AUX_TX: U1.16 (GPIO12); also elsewhere on the board
/BUZZ: U1.29 (GPIO18); also elsewhere on the board
/CUR_SENSE: U1.41 (GPIO27/ADC1); also elsewhere on the board
/ESC_TEL: U1.34 (GPIO22); also elsewhere on the board
/I2C_SCL: U1.19 (GPIO15); also elsewhere on the board
/I2C_SDA: U1.18 (GPIO14); also elsewhere on the board
/IMU_CS: U1.8 (GPIO5); also elsewhere on the board
/IMU_INT1: U1.9 (GPIO6); also elsewhere on the board
/IMU_MISO: U1.7 (GPIO4); also elsewhere on the board
/IMU_MOSI: U1.5 (GPIO3); also elsewhere on the board
/IMU_SCK: U1.4 (GPIO2); also elsewhere on the board
/M1: U1.12 (GPIO8); also elsewhere on the board
/M2: U1.13 (GPIO9); also elsewhere on the board
/M3: U1.14 (GPIO10); also elsewhere on the board
/M4: U1.15 (GPIO11); also elsewhere on the board
/MCU/BOOT_SW: R5.2, SW1.1
/MCU/DVDD: C1.1, C2.1, C3.1, C16.1, L2.1, U1.6 (DVDD), U1.23 (DVDD), U1.39 (DVDD), U1.50 (VREG_FB)
/MCU/QSPI_SCLK: U1.56 (QSPI_SCLK), U2.6 (CLK)
/MCU/QSPI_SD0: U1.57 (QSPI_SD0), U2.5 (DI(IO0))
/MCU/QSPI_SD1: U1.59 (QSPI_SD1), U2.2 (DO(IO1))
/MCU/QSPI_SD2: U1.58 (QSPI_SD2), U2.3 (IO2)
/MCU/QSPI_SD3: U1.55 (QSPI_SD3), U2.7 (IO3)
/MCU/QSPI_SS: R2.2, R5.1, U1.60 (QSPI_~CS), U2.1 (~CS)
/MCU/RUN: C20.1, R4.2, TP1.1, U1.26 (RUN)
/MCU/SWCLK: J4.1 (SWCLK), U1.24 (SWCLK)
/MCU/SWDIO: J4.3 (SWDIO), U1.25 (SWDIO)
/MCU/VREG_AVDD: C4.1, R1.2, U1.46 (VREG_AVDD)
/MCU/VREG_LX: L2.2, U1.48 (VREG_LX)
/MCU/XIN: C18.1, U1.21 (XIN), Y1.1
/MCU/XOUT: R3.1, U1.22 (XOUT)
/MCU/XOUT_X: C19.1, R3.2, Y1.3
/RSSI: U1.42 (GPIO28/ADC2); also elsewhere on the board
/RX_RX: U1.3 (GPIO1); also elsewhere on the board
/RX_TX: U1.2 (GPIO0); also elsewhere on the board
/STATUS_LED: U1.28 (GPIO17); also elsewhere on the board
/USB_DM: U1.51 (USB_D-); also elsewhere on the board
/USB_DP: U1.52 (USB_D+); also elsewhere on the board
/VBAT_SENSE: U1.40 (GPIO26/ADC0); also elsewhere on the board
/WS_DATA: U1.27 (GPIO16); also elsewhere on the board
GND: C1.2, C2.2, C3.2, C4.2, C5.2, C6.2, C7.2, C8.2, C9.2, C10.2, C11.2, C12.2, C13.2, C14.2, C15.2, C16.2, C17.2, C18.2, C19.2, C20.2, J4.2 (GND), J4.MP, SW1.2, U1.47 (VREG_PGND), U1.EP (GND), U2.4 (GND), Y1.2 (GND), Y1.4 (GND); also elsewhere on the board

Notes on the sheet:
RP2350A
1.1 V core regulator (on-chip SMPS)
3.3 V decoupling — 100 nF at each IOVDD / QSPI / OTP / ADC pin
QSPI flash
12 MHz crystal
Reset, BOOTSEL & SWD
Power flags (ERC drivers)

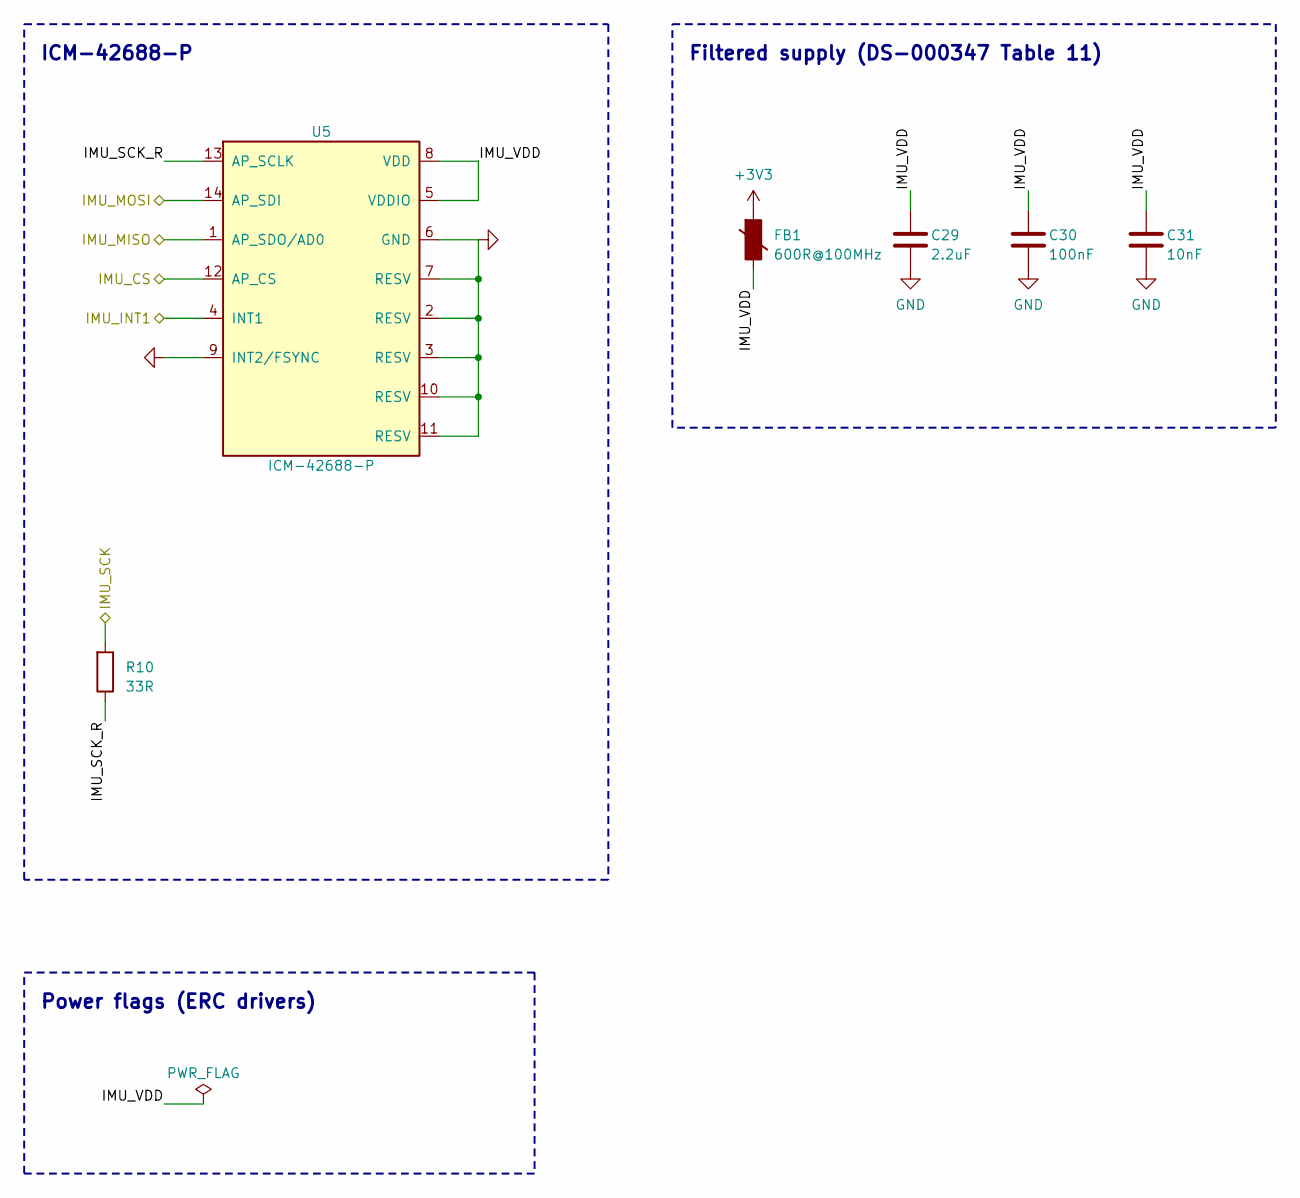
[picture p12: schematic imu.kicad_sch, IMU — ICM-42688-P on SPI0]

Parts:
C29: 2.2uF; C_0603_1608Metric; LCSC C23630
C30: 100nF; C_0402_1005Metric; LCSC C1525
C31: 10nF; C_0402_1005Metric; MPN C0402C103J5RAC7867 (KEMET); LCSC C696350
FB1: 600R@100MHz; L_0603_1608Metric; MPN GZ1608D601TF (Sunlord); LCSC C1002
R10: 33R; R_0402_1005Metric; LCSC C25105
U5: ICM-42688-P; ICM-42688-P_LGA-14_2.5x3.0mm_P0.5mm; MPN ICM-42688-P (TDK InvenSense); LCSC C1850418

Connections:
+3V3: FB1.1; also elsewhere on the board
/IMU/IMU_SCK_R: R10.2, U5.13 (AP_SCLK)
/IMU/IMU_VDD: C29.1, C30.1, C31.1, FB1.2, U5.5 (VDDIO), U5.8 (VDD)
/IMU_CS: U5.12 (AP_CS); also elsewhere on the board
/IMU_INT1: U5.4 (INT1); also elsewhere on the board
/IMU_MISO: U5.1 (AP_SDO/AD0); also elsewhere on the board
/IMU_MOSI: U5.14 (AP_SDI); also elsewhere on the board
/IMU_SCK: R10.1; also elsewhere on the board
GND: C29.2, C30.2, C31.2, U5.2 (RESV), U5.3 (RESV), U5.6 (GND), U5.7 (RESV), U5.9 (INT2/FSYNC), U5.10 (RESV), U5.11 (RESV); also elsewhere on the board

Notes on the sheet:
ICM-42688-P
Filtered supply (DS-000347 Table 11)
Power flags (ERC drivers)

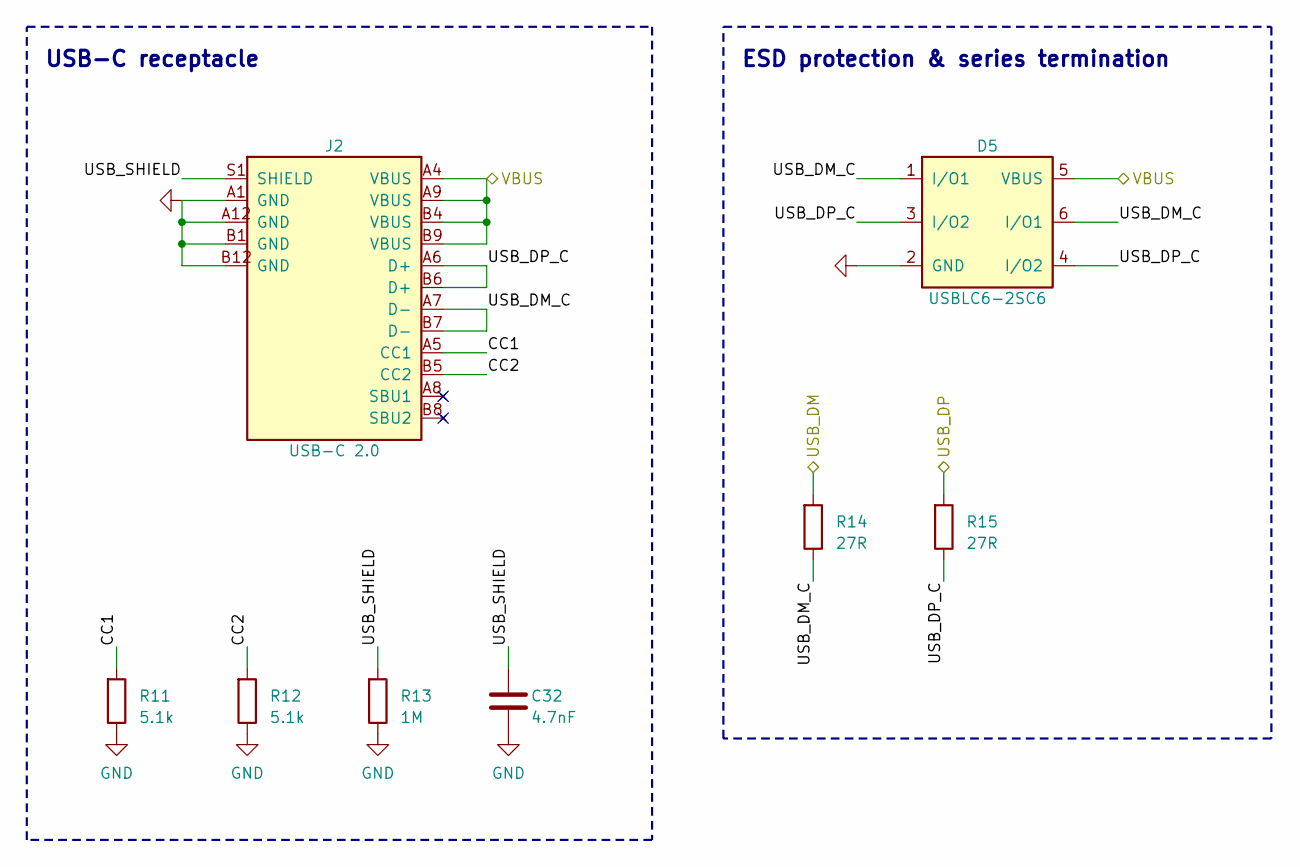
[picture p13: schematic usb.kicad_sch, USB-C — flashing and debug console]

Parts:
C32: 4.7nF; C_0402_1005Metric; LCSC C1538
D5: USBLC6-2SC6; SOT-23-6; MPN USBLC6-2SC6 (ST); LCSC C7519
J2: USB-C 2.0; USB_C_Receptacle_GCT_USB4085-GF-A; MPN USB4085-GF-A (GCT)
R11, R12: 5.1k; R_0402_1005Metric; LCSC C25905
R13: 1M; R_0402_1005Metric; LCSC C26083
R14, R15: 27R; RPI_R_0402_resc1005x35; LCSC C25100

Connections:
/USB/CC1: J2.A5 (CC1), R11.1
/USB/CC2: J2.B5 (CC2), R12.1
/USB/USB_DM_C: D5.1 (I/O1), D5.6 (I/O1), J2.A7 (D-), J2.B7 (D-), R14.2
/USB/USB_DP_C: D5.3 (I/O2), D5.4 (I/O2), J2.A6 (D+), J2.B6 (D+), R15.2
/USB/USB_SHIELD: C32.1, J2.S1 (SHIELD), R13.1
/USB_DM: R14.1; also elsewhere on the board
/USB_DP: R15.1; also elsewhere on the board
/VBUS: D5.5 (VBUS), J2.A4 (VBUS), J2.A9 (VBUS), J2.B4 (VBUS), J2.B9 (VBUS); also elsewhere on the board
GND: C32.2, D5.2 (GND), J2.A1 (GND), J2.A12 (GND), J2.B1 (GND), J2.B12 (GND), R11.2, R12.2, R13.2; also elsewhere on the board

Notes on the sheet:
USB-C receptacle
ESD protection & series termination

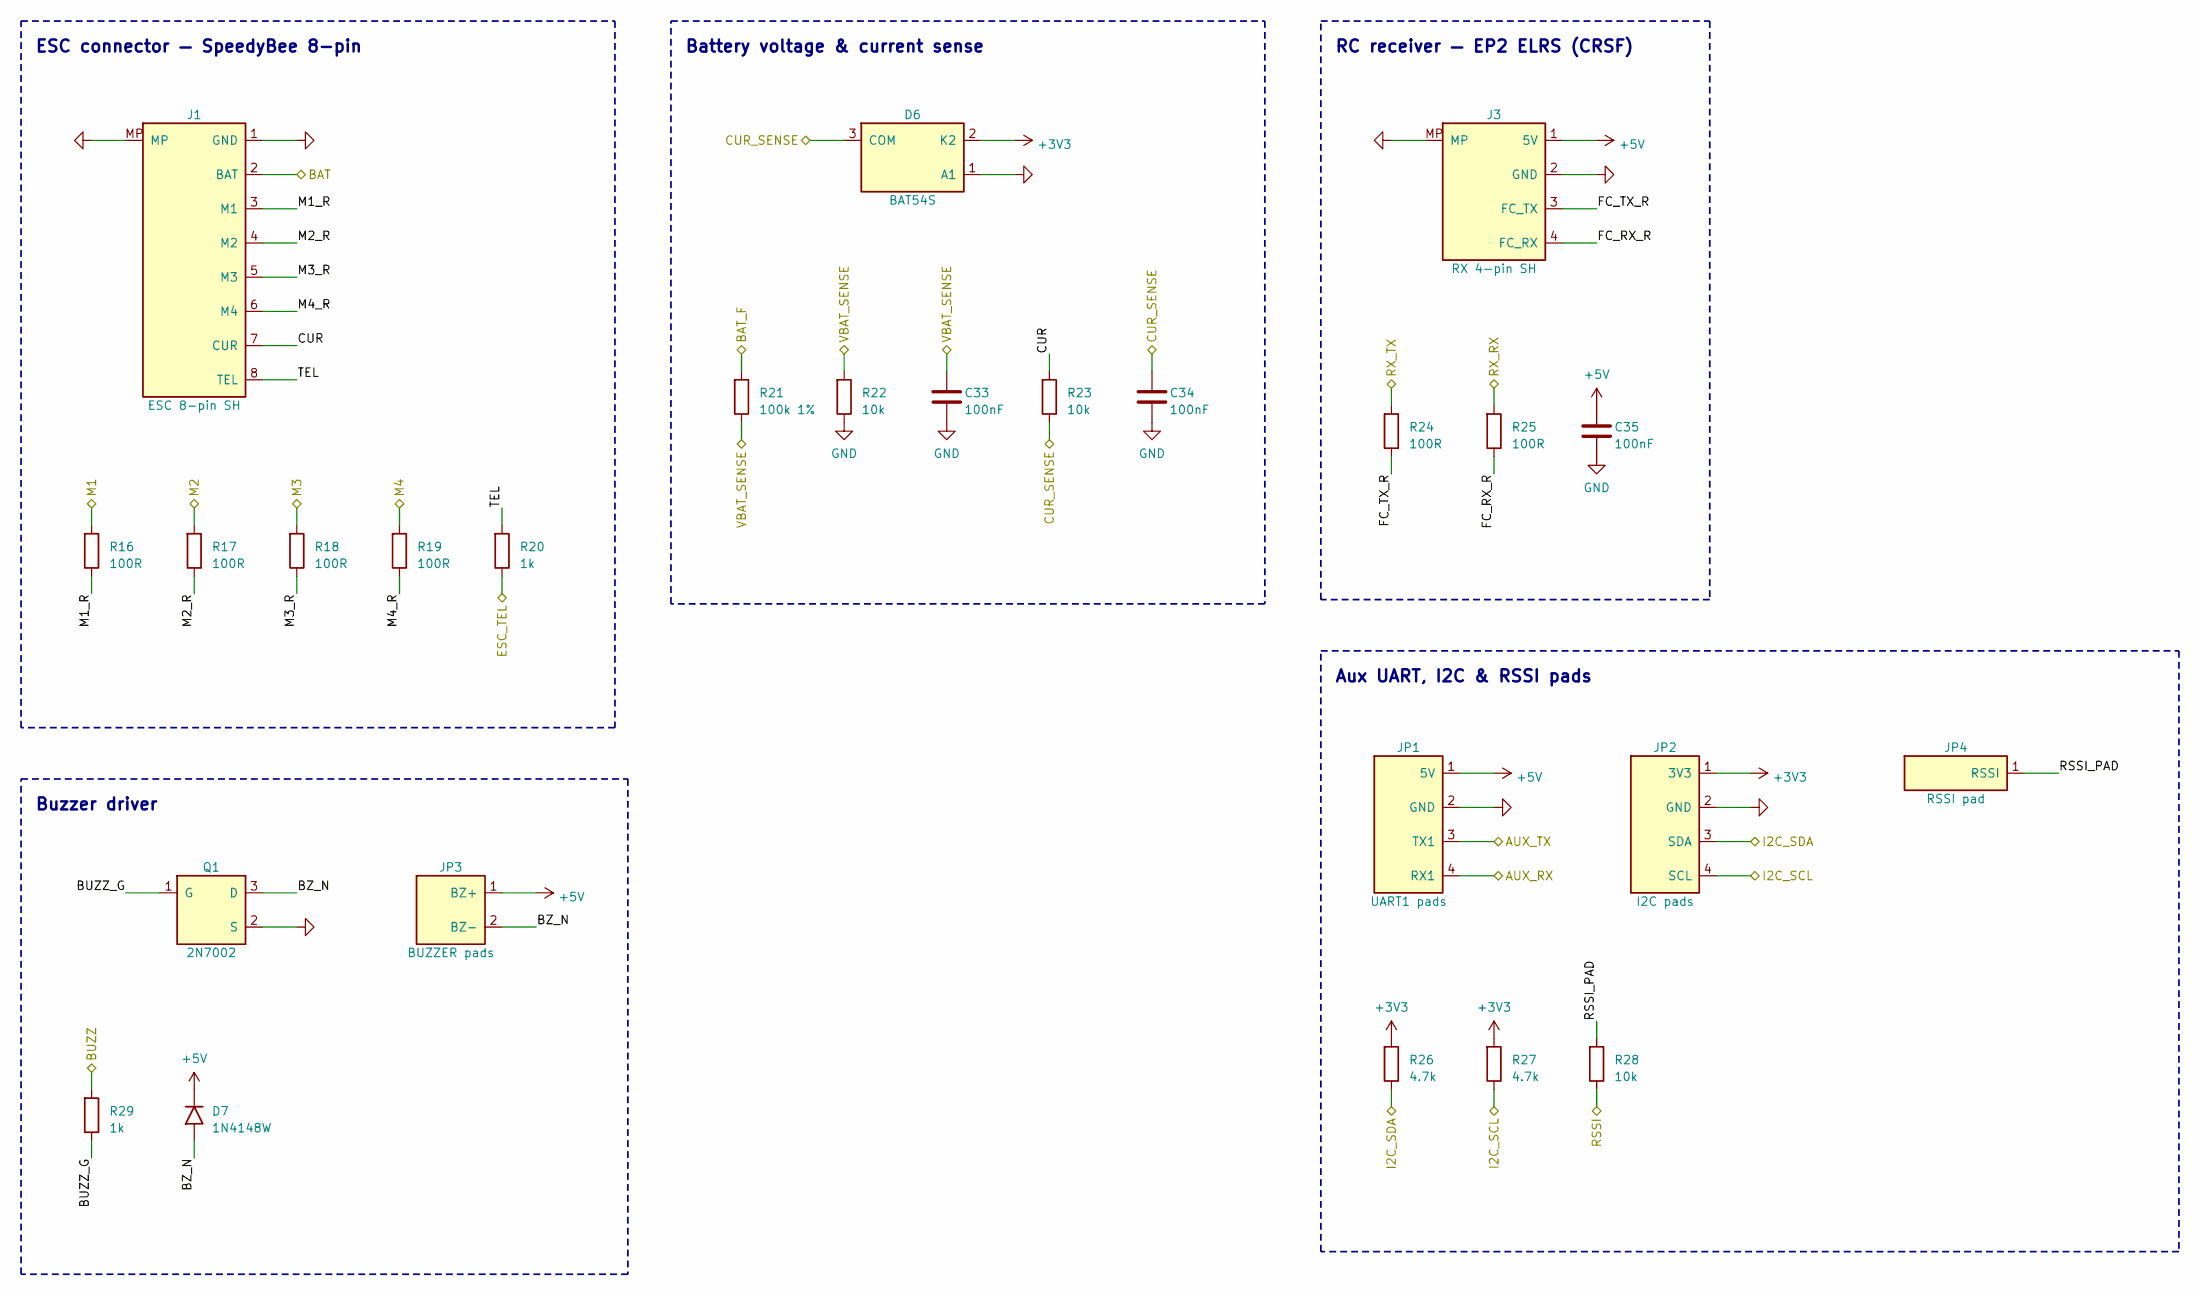
[picture p14: schematic io.kicad_sch, ESC, RC receiver and auxiliary I/O]

Parts:
C33, C34, C35: 100nF; C_0402_1005Metric; LCSC C1525
D6: BAT54S; SOT-23; MPN BAT54S; LCSC C7420333
D7: 1N4148W; D_SOD-123; MPN 1N4148W; LCSC C81598
J1: ESC 8-pin SH; JST_SH_SM08B-SRSS-TB_1x08-1MP_P1.00mm_Horizontal; MPN SM08B-SRSS-TB (JST)
J3: RX 4-pin SH; JST_SH_SM04B-SRSS-TB_1x04-1MP_P1.00mm_Horizontal; MPN SM04B-SRSS-TB (JST)
JP1: UART1 pads; PinHeader_1x04_P1.27mm_Vertical
JP2: I2C pads; PinHeader_1x04_P1.27mm_Vertical
JP3: BUZZER pads; PinHeader_1x02_P1.27mm_Vertical
JP4: RSSI pad; PinHeader_1x01_P1.27mm_Vertical
Q1: 2N7002; SOT-23; MPN 2N7002; LCSC C8545
R16, R17, R18, R19, R24, R25: 100R; R_0402_1005Metric; LCSC C25076
R20, R29: 1k; R_0402_1005Metric; LCSC C11702
R21: 100k 1%; R_0402_1005Metric; LCSC C25741
R22, R23, R28: 10k; R_0402_1005Metric; LCSC C25744
R26, R27: 4.7k; R_0402_1005Metric; LCSC C25900

Connections:
+3V3: D6.2 (K2), JP2.1 (3V3), R26.1, R27.1; also elsewhere on the board
+5V: C35.1, D7.1, J3.1 (5V), JP1.1 (5V), JP3.1 (BZ+); also elsewhere on the board
/AUX_RX: JP1.4 (RX1); also elsewhere on the board
/AUX_TX: JP1.3 (TX1); also elsewhere on the board
/BAT: J1.2 (BAT); also elsewhere on the board
/BAT_F: R21.1; also elsewhere on the board
/BUZZ: R29.1; also elsewhere on the board
/CUR_SENSE: C34.1, D6.3 (COM), R23.2; also elsewhere on the board
/ESC_TEL: R20.2; also elsewhere on the board
/I2C_SCL: JP2.4 (SCL), R27.2; also elsewhere on the board
/I2C_SDA: JP2.3 (SDA), R26.2; also elsewhere on the board
/IO/BUZZ_G: Q1.1 (G), R29.2
/IO/BZ_N: D7.2, JP3.2 (BZ-), Q1.3 (D)
/IO/CUR: J1.7 (CUR), R23.1
/IO/FC_RX_R: J3.4 (FC_RX), R25.2
/IO/FC_TX_R: J3.3 (FC_TX), R24.2
/IO/M1_R: J1.3 (M1), R16.2
/IO/M2_R: J1.4 (M2), R17.2
/IO/M3_R: J1.5 (M3), R18.2
/IO/M4_R: J1.6 (M4), R19.2
/IO/RSSI_PAD: JP4.1, R28.1
/IO/TEL: J1.8 (TEL), R20.1
/M1: R16.1; also elsewhere on the board
/M2: R17.1; also elsewhere on the board
/M3: R18.1; also elsewhere on the board
/M4: R19.1; also elsewhere on the board
/RSSI: R28.2; also elsewhere on the board
/RX_RX: R25.1; also elsewhere on the board
/RX_TX: R24.1; also elsewhere on the board
/VBAT_SENSE: C33.1, R21.2, R22.1; also elsewhere on the board
GND: C33.2, C34.2, C35.2, D6.1 (A1), J1.1 (GND), J1.MP, J3.2 (GND), J3.MP, JP1.2 (GND), JP2.2 (GND), Q1.2 (S), R22.2; also elsewhere on the board

Notes on the sheet:
ESC connector — SpeedyBee 8-pin
Battery voltage & current sense
RC receiver — EP2 ELRS (CRSF)
Aux UART, I2C & RSSI pads
Buzzer driver

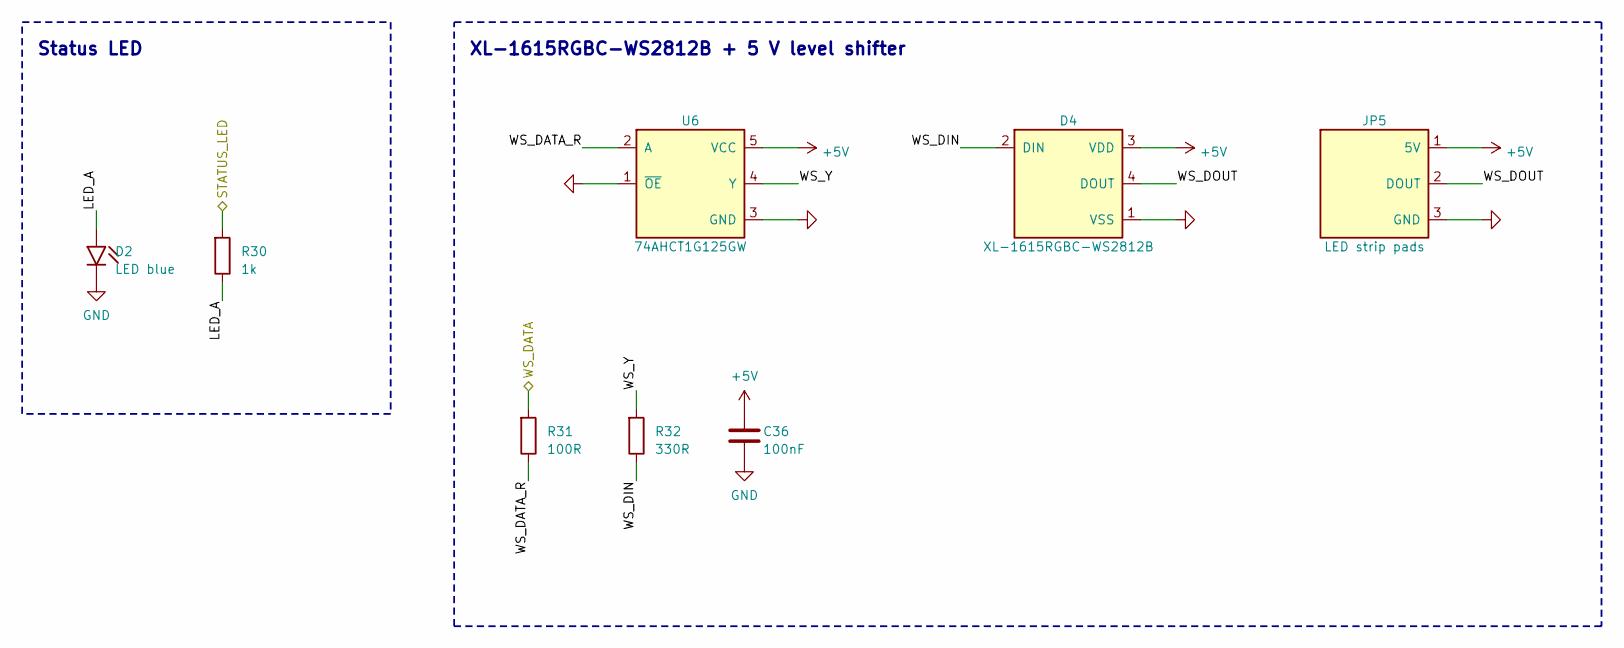
[picture p15: schematic leds.kicad_sch, LEDs — status LED and XL-1615 RGB LED]

Parts:
C36: 100nF; C_0402_1005Metric; LCSC C1525
D2: LED blue; LED_0603_1608Metric; LCSC C125096
D4: XL-1615RGBC-WS2812B; LED_XL-1615RGBC-WS2812B; MPN XL-1615RGBC-WS2812B (XINGLIGHT); LCSC C5349954
JP5: LED strip pads; PinHeader_1x03_P1.27mm_Vertical
R30: 1k; R_0402_1005Metric; LCSC C11702
R31: 100R; R_0402_1005Metric; LCSC C25076
R32: 330R; R_0402_1005Metric; LCSC C25104
U6: 74AHCT1G125GW; SOT-353_SC-70-5; MPN 74AHCT1G125GW (Nexperia); LCSC C52953352

Connections:
+5V: C36.1, D4.3 (VDD), JP5.1 (5V), U6.5 (VCC); also elsewhere on the board
/LEDs/LED_A: D2.2, R30.2
/LEDs/WS_DATA_R: R31.2, U6.2 (A)
/LEDs/WS_DIN: D4.2 (DIN), R32.2
/LEDs/WS_DOUT: D4.4 (DOUT), JP5.2 (DOUT)
/LEDs/WS_Y: R32.1, U6.4 (Y)
/STATUS_LED: R30.1; also elsewhere on the board
/WS_DATA: R31.1; also elsewhere on the board
GND: C36.2, D2.1, D4.1 (VSS), JP5.3 (GND), U6.1 (~OE), U6.3 (GND); also elsewhere on the board

Notes on the sheet:
Status LED
XL-1615RGBC-WS2812B + 5 V level shifter

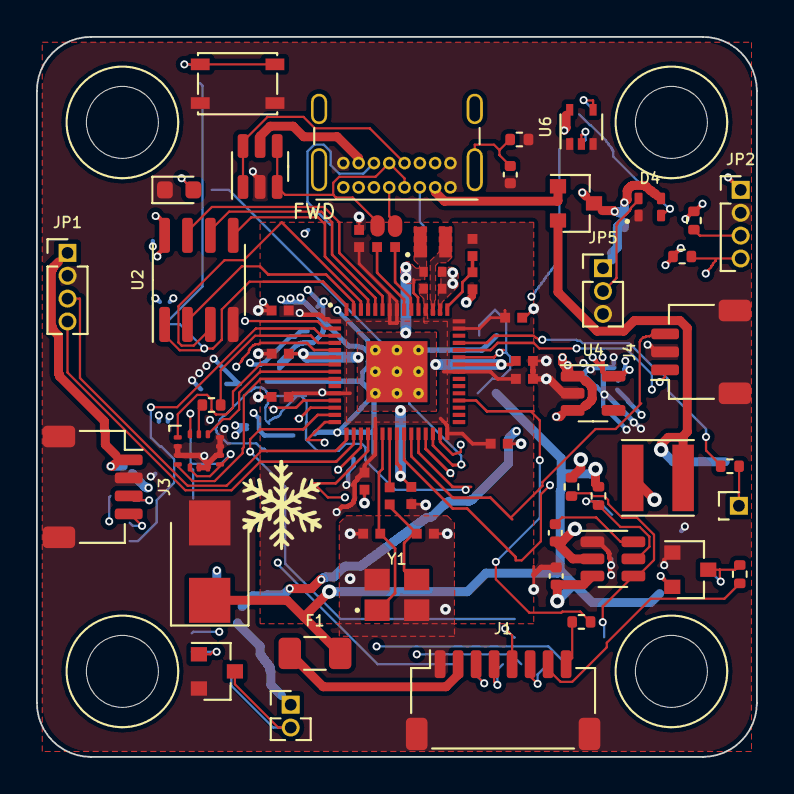
[picture p16: board snowboard_fc.kicad_pcb from above]

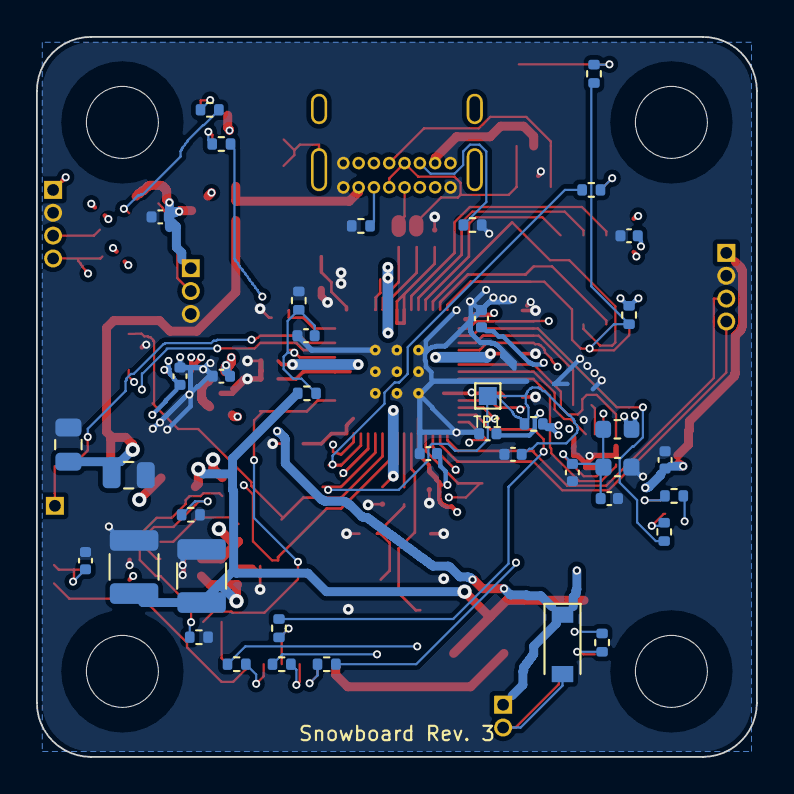
[picture p17: board snowboard_fc.kicad_pcb from below]

Board: 4 copper layers, 40.0 x 40.0 mm, 102 parts (40 on the bottom side), 74 nets.

Other parts of the board:
H1, H2, H3, H4: M3 grommet 4.0mm; MountingHole_4.0mm_Grommet
