RotemCarr/snowboard-fc/(commit log)

2026-10-16 Initial commit :)
    [imu.kicad_sch, io.kicad_sch, leds.kicad_sch, mcu.kicad_sch, power.kicad_sch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]
2026-10-19 Update CPL file to latest revision
    [snowboard_fc_JLC_CPL_v8.csv]
2026-11-06 bump zephyr version from 4.4.2 to 4.5.0 rename snowboard definition files to match the new zephyr version update to avoid 4.4.2 icm42688 driver bugs
2026-11-06 Update CI to new board name and update zephyr version in README
